huddlwenf/vedlegg_E1534A/Vedlegg_5_Applikasjon_Firmware/ble_moisture_sensor_system/pca10028/s110/arm5/JLinkLog.txt

T217C 000:562 SEGGER J-Link V4.96d Log File (0000ms, 0530ms total)
T217C 000:562 DLL Compiled: Jan 29 2015 11:45:37 (0000ms, 0530ms total)
T217C 000:562 Logging started @ 2015-05-24 15:23 (0000ms, 0530ms total)
T217C 000:563 JLINK_SetWarnOutHandler(...) (0000ms, 0530ms total)
T217C 000:563 JLINK_OpenEx(...)
Firmware: J-Link OB-SAM3U128-V2-NordicSemi compiled Nov 28 2014 10:32:04
Hardware: V1.00
S/N: 681368549  returns O.K. (0266ms, 0796ms total)
T217C 000:829 JLINK_SetErrorOutHandler(...) (0000ms, 0796ms total)
T217C 000:829 JLINK_ExecCommand("ProjectFile = "C:\Users\Joakim\Downloads\ble_peripheral\ble_moisture_sensor_system\pca10028\s110\arm5\JLinkSettings.ini"", ...)  returns 0x00 (0001ms, 0797ms total)
T217C 000:839 JLINK_ExecCommand("Device = nRF51422_xxAC", ...)Device "NRF51422_XXAC" selected.  returns 0x00 (0004ms, 0801ms total)
T217C 000:843 JLINK_ExecCommand("DisableConnectionTimeout", ...)  returns 0x01 (0000ms, 0801ms total)
T217C 000:843 JLINK_GetHardwareVersion()  returns 0x2710 (0001ms, 0802ms total)
T217C 000:844 JLINK_GetDLLVersion()  returns 49604 (0000ms, 0802ms total)
T217C 000:844 JLINK_GetFirmwareString(...) (0000ms, 0802ms total)
T217C 000:852 JLINK_GetDLLVersion()  returns 49604 (0000ms, 0802ms total)
T217C 000:852 JLINK_GetCompileDateTime() (0000ms, 0802ms total)
T217C 000:855 JLINK_GetFirmwareString(...) (0000ms, 0802ms total)
T217C 000:860 JLINK_GetHardwareVersion()  returns 0x2710 (0000ms, 0802ms total)
T217C 000:865 JLINK_TIF_Select(JLINKARM_TIF_SWD)  returns 0x00 (0002ms, 0804ms total)
T217C 000:867 JLINK_SetSpeed(20000) (0001ms, 0805ms total)
T217C 000:868 JLINK_GetId() >0x108 TIF>Found SWD-DP with ID 0x0BB11477 >0x35 TIF> >0x0D TIF> >0x28 TIF> >0x0D TIF> >0x28 TIF> >0x35 TIF> >0x0D TIF> >0x28 TIF> >0x35 TIF> >0x35 TIF> >0x35 TIF> >0x0D TIF> >0x28 TIF> >0x0D TIF> >0x28 TIF> >0x0D TIF> >0x28 TIF> >0x35 TIF> >0x35 TIF> >0x35 TIF> >0x0D TIF> >0x28 TIF> >0x0D TIF> >0x28 TIF> >0x35 TIF> >0x0D TIF> >0x28 TIF> >0x0D TIF> >0x28 TIF> >0x0D TIF> >0x28 TIF> >0x35 TIF> >0x35 TIF> >0x0D TIF> >0x28 TIF> >0x35 TIF> >0x35 TIF>
Found Cortex-M0 r0p0, Little endian. -- CPU_WriteMem(4 bytes @ 0xE0002000) -- CPU_ReadMem(4 bytes @ 0xE000EDF0) -- CPU_ReadMem(4 bytes @ 0xE0002000)FPUnit: 4 code (BP) slots and 0 literal slots -- CPU_ReadMem(4 bytes @ 0xE000EDFC) -- CPU_ReadMem(4 bytes @ 0xE0001000) -- CPU_WriteMem(4 bytes @ 0xE0001000) -- CPU_ReadMem(4 bytes @ 0xE00FF018) >0x35 TIF>  returns 0x0BB11477 (0032ms, 0837ms total)
T217C 000:900 JLINK_GetDLLVersion()  returns 49604 (0001ms, 0838ms total)
T217C 000:901 JLINK_CORE_GetFound()  returns 0x60000FF (0000ms, 0838ms total)
T217C 000:901 JLINK_GetDebugInfo(0x100) -- Value=0xF0000003  returns 0x00 (0000ms, 0838ms total)
T217C 000:902 JLINK_ReadMem (0xF0000000, 0x0020 Bytes, ...) -- CPU is running -- CPU_ReadMem(32 bytes @ 0xF0000000) - Data: 03 F0 0F F0 03 20 00 00 00 00 00 00 00 00 00 00 ...  returns 0x00 (0002ms, 0840ms total)
T217C 000:904 JLINK_ReadMem (0xE00FFFF0, 0x0010 Bytes, ...) -- CPU is running -- CPU_ReadMem(16 bytes @ 0xE00FFFF0) - Data: 0D 00 00 00 10 00 00 00 05 00 00 00 B1 00 00 00  returns 0x00 (0000ms, 0840ms total)
T217C 000:904 JLINK_ReadMem (0xE00FFFD0, 0x0020 Bytes, ...) -- CPU is running -- CPU_ReadMem(32 bytes @ 0xE00FFFD0) - Data: 04 00 00 00 00 00 00 00 00 00 00 00 00 00 00 00 ...  returns 0x00 (0002ms, 0842ms total)
T217C 000:906 JLINK_ReadMem (0xE00FF000, 0x0020 Bytes, ...) -- CPU is running -- CPU_ReadMem(32 bytes @ 0xE00FF000) - Data: 03 F0 F0 FF 03 20 F0 FF 03 30 F0 FF 00 00 00 00 ...  returns 0x00 (0001ms, 0843ms total)
T217C 000:907 JLINK_ReadMem (0xE000EFF0, 0x0010 Bytes, ...) -- CPU is running -- CPU_ReadMem(16 bytes @ 0xE000EFF0) - Data: 0D 00 00 00 E0 00 00 00 05 00 00 00 B1 00 00 00  returns 0x00 (0001ms, 0844ms total)
T217C 000:908 JLINK_ReadMem (0xE000EFD0, 0x0020 Bytes, ...) -- CPU is running -- CPU_ReadMem(32 bytes @ 0xE000EFD0) - Data: 04 00 00 00 00 00 00 00 00 00 00 00 00 00 00 00 ...  returns 0x00 (0001ms, 0845ms total)
T217C 000:909 JLINK_ReadMem (0xE0001FF0, 0x0010 Bytes, ...) -- CPU is running -- CPU_ReadMem(16 bytes @ 0xE0001FF0) - Data: 0D 00 00 00 E0 00 00 00 05 00 00 00 B1 00 00 00  returns 0x00 (0001ms, 0846ms total)
T217C 000:910 JLINK_ReadMem (0xE0001FD0, 0x0020 Bytes, ...) -- CPU is running -- CPU_ReadMem(32 bytes @ 0xE0001FD0) - Data: 04 00 00 00 00 00 00 00 00 00 00 00 00 00 00 00 ...  returns 0x00 (0001ms, 0847ms total)
T217C 000:911 JLINK_ReadMem (0xE0002FF0, 0x0010 Bytes, ...) -- CPU is running -- CPU_ReadMem(16 bytes @ 0xE0002FF0) - Data: 0D 00 00 00 E0 00 00 00 05 00 00 00 B1 00 00 00  returns 0x00 (0001ms, 0848ms total)
T217C 000:912 JLINK_ReadMem (0xE0002FD0, 0x0020 Bytes, ...) -- CPU is running -- CPU_ReadMem(32 bytes @ 0xE0002FD0) - Data: 04 00 00 00 00 00 00 00 00 00 00 00 00 00 00 00 ...  returns 0x00 (0002ms, 0850ms total)
T217C 000:914 JLINK_ReadMem (0xF0002FF0, 0x0010 Bytes, ...) -- CPU is running -- CPU_ReadMem(16 bytes @ 0xF0002FF0) - Data: 0D 00 00 00 90 00 00 00 05 00 00 00 B1 00 00 00  returns 0x00 (0001ms, 0851ms total)
T217C 000:915 JLINK_ReadMem (0xF0002FD0, 0x0020 Bytes, ...) -- CPU is running -- CPU_ReadMem(32 bytes @ 0xF0002FD0) - Data: 04 00 00 00 00 00 00 00 00 00 00 00 00 00 00 00 ...  returns 0x00 (0001ms, 0852ms total)
T217C 000:916 JLINK_ReadMemU32(0xE000ED00, 0x0001 Items, ...) -- CPU is running -- CPU_ReadMem(4 bytes @ 0xE000ED00) - Data: 00 C2 0C 41  returns 0x01 (0001ms, 0853ms total)
T217C 000:917 JLINK_SetResetType(JLINKARM_RESET_TYPE_NORMAL)  returns JLINKARM_RESET_TYPE_NORMAL (0000ms, 0853ms total)
T217C 000:917 JLINK_Reset() -- CPU is running -- CPU_WriteMem(4 bytes @ 0xE000EDF0) -- CPU is running -- CPU_WriteMem(4 bytes @ 0xE000EDFC) >0x35 TIF> -- CPU is running -- CPU_WriteMem(4 bytes @ 0xE000ED0C) -- CPU is running -- CPU_ReadMem(4 bytes @ 0xE000EDF0) -- CPU is running -- CPU_ReadMem(4 bytes @ 0xE000EDF0) -- CPU is running -- CPU_WriteMem(4 bytes @ 0xE000EDF0) -- CPU is running -- CPU_WriteMem(4 bytes @ 0xE000EDFC) -- CPU is running -- CPU_ReadMem(4 bytes @ 0xE000EDF0)
 -- CPU_WriteMem(4 bytes @ 0xE0002000) -- CPU_ReadMem(4 bytes @ 0xE000EDFC) -- CPU_ReadMem(4 bytes @ 0xE0001000) -- CPU_WriteMem(4 bytes @ 0xE0001000) (0027ms, 0880ms total)
T217C 000:944 JLINK_Halt()  returns 0x00 (0000ms, 0880ms total)
T217C 000:944 JLINK_IsHalted()  returns TRUE (0000ms, 0880ms total)
T217C 000:944 JLINK_ReadMemU32(0xE000EDF0, 0x0001 Items, ...) -- CPU_ReadMem(4 bytes @ 0xE000EDF0) - Data: 03 00 03 00  returns 0x01 (0001ms, 0881ms total)
T217C 000:945 JLINK_WriteU32(0xE000EDF0, 0xA05F0003) -- CPU_WriteMem(4 bytes @ 0xE000EDF0)  returns 0x00 (0001ms, 0882ms total)
T217C 000:946 JLINK_WriteU32(0xE000EDFC, 0x01000000) -- CPU_WriteMem(4 bytes @ 0xE000EDFC)  returns 0x00 (0001ms, 0883ms total)
T217C 000:954 JLINK_GetHWStatus(...)  returns 0x00 (0000ms, 0883ms total)
T217C 000:960 JLINK_GetNumBPUnits(Type = 0xFFFFFF00)  returns 0x04 (0000ms, 0883ms total)
T217C 000:960 JLINK_GetNumBPUnits(Type = 0xF0)  returns 0x2000 (0000ms, 0883ms total)
T217C 000:960 JLINK_GetNumWPUnits()  returns 0x02 (0000ms, 0883ms total)
T217C 000:967 JLINK_GetSpeed()  returns 0x3E8 (0000ms, 0883ms total)
T217C 000:970 JLINK_ReadMemU32(0xE000E004, 0x0001 Items, ...) -- CPU_ReadMem(4 bytes @ 0xE000E004) - Data: 00 00 00 00  returns 0x01 (0001ms, 0884ms total)
T217C 000:971 JLINK_Halt()  returns 0x00 (0000ms, 0884ms total)
T217C 000:971 JLINK_IsHalted()  returns TRUE (0000ms, 0884ms total)
T217C 001:067 JLINK_WriteMem(0x20000000, 0x0470 Bytes, ...) - Data: 00 BE 0A E0 0D 78 2D 06 68 40 08 24 40 00 00 D3 ... -- CPU_WriteMem(1136 bytes @ 0x20000000)  returns 0x470 (0019ms, 0903ms total)
T217C 001:086 JLINK_WriteReg(R0, 0x00000000)  returns 0x00 (0000ms, 0903ms total)
T217C 001:086 JLINK_WriteReg(R1, 0x00F42400)  returns 0x00 (0000ms, 0903ms total)
T217C 001:086 JLINK_WriteReg(R2, 0x00000001)  returns 0x00 (0000ms, 0903ms total)
T217C 001:086 JLINK_WriteReg(R3, 0x00000000)  returns 0x00 (0000ms, 0903ms total)
T217C 001:086 JLINK_WriteReg(R4, 0x00000000)  returns 0x00 (0000ms, 0903ms total)
T217C 001:086 JLINK_WriteReg(R5, 0x00000000)  returns 0x00 (0000ms, 0903ms total)
T217C 001:086 JLINK_WriteReg(R6, 0x00000000)  returns 0x00 (0000ms, 0903ms total)
T217C 001:086 JLINK_WriteReg(R7, 0x00000000)  returns 0x00 (0000ms, 0903ms total)
T217C 001:086 JLINK_WriteReg(R8, 0x00000000)  returns 0x00 (0000ms, 0903ms total)
T217C 001:086 JLINK_WriteReg(R9, 0x2000046C)  returns 0x00 (0000ms, 0903ms total)
T217C 001:086 JLINK_WriteReg(R10, 0x00000000)  returns 0x00 (0000ms, 0903ms total)
T217C 001:086 JLINK_WriteReg(R11, 0x00000000)  returns 0x00 (0000ms, 0903ms total)
T217C 001:086 JLINK_WriteReg(R12, 0x00000000)  returns 0x00 (0000ms, 0903ms total)
T217C 001:086 JLINK_WriteReg(R13 (SP), 0x20001000)  returns 0x00 (0000ms, 0903ms total)
T217C 001:086 JLINK_WriteReg(R14, 0x20000001)  returns 0x00 (0000ms, 0903ms total)
T217C 001:086 JLINK_WriteReg(R15 (PC), 0x20000028)  returns 0x00 (0000ms, 0903ms total)
T217C 001:086 JLINK_WriteReg(XPSR, 0x01000000)  returns 0x00 (0000ms, 0903ms total)
T217C 001:086 JLINK_WriteReg(MSP, 0x20001000)  returns 0x00 (0000ms, 0903ms total)
T217C 001:086 JLINK_WriteReg(PSP, 0x20001000)  returns 0x00 (0000ms, 0903ms total)
T217C 001:086 JLINK_WriteReg(CFBP, 0x00000000)  returns 0x00 (0000ms, 0903ms total)
T217C 001:086 JLINK_SetBPEx(Addr = 0x20000000, Type = 0xFFFFFFF2) -- CPU_ReadMem(2 bytes @ 0x20000000)  returns 0x00000001 (0002ms, 0905ms total)
T217C 001:088 JLINK_Go() -- CPU_WriteMem(2 bytes @ 0x20000000) -- CPU_WriteMem(4 bytes @ 0xE0002008) -- CPU_WriteMem(4 bytes @ 0xE000200C) -- CPU_WriteMem(4 bytes @ 0xE0002010) -- CPU_WriteMem(4 bytes @ 0xE0002014) -- CPU_WriteMem(4 bytes @ 0xE0001004) (0009ms, 0914ms total)
T217C 001:097 JLINK_IsHalted() -- CPU_ReadMem(2 bytes @ 0x20000000)  returns TRUE (0006ms, 0920ms total)
T217C 001:103 JLINK_ReadReg(R15 (PC))  returns 0x20000000 (0000ms, 0914ms total)
T217C 001:103 JLINK_ClrBPEx(BPHandle = 0x00000001)  returns 0x00 (0000ms, 0914ms total)
T217C 001:103 JLINK_ReadReg(R0)  returns 0x00000000 (0000ms, 0914ms total)
T217C 001:104 JLINK_WriteReg(R0, 0x00018000)  returns 0x00 (0000ms, 0914ms total)
T217C 001:104 JLINK_WriteReg(R1, 0x00000400)  returns 0x00 (0000ms, 0914ms total)
T217C 001:104 JLINK_WriteReg(R2, 0x000000FF)  returns 0x00 (0000ms, 0914ms total)
T217C 001:104 JLINK_WriteReg(R3, 0x00000000)  returns 0x00 (0000ms, 0914ms total)
T217C 001:104 JLINK_WriteReg(R4, 0x00000000)  returns 0x00 (0000ms, 0914ms total)
T217C 001:104 JLINK_WriteReg(R5, 0x00000000)  returns 0x00 (0000ms, 0914ms total)
T217C 001:104 JLINK_WriteReg(R6, 0x00000000)  returns 0x00 (0000ms, 0914ms total)
T217C 001:104 JLINK_WriteReg(R7, 0x00000000)  returns 0x00 (0000ms, 0914ms total)
T217C 001:104 JLINK_WriteReg(R8, 0x00000000)  returns 0x00 (0000ms, 0914ms total)
T217C 001:104 JLINK_WriteReg(R9, 0x2000046C)  returns 0x00 (0000ms, 0914ms total)
T217C 001:104 JLINK_WriteReg(R10, 0x00000000)  returns 0x00 (0000ms, 0914ms total)
T217C 001:104 JLINK_WriteReg(R11, 0x00000000)  returns 0x00 (0000ms, 0914ms total)
T217C 001:104 JLINK_WriteReg(R12, 0x00000000)  returns 0x00 (0000ms, 0914ms total)
T217C 001:104 JLINK_WriteReg(R13 (SP), 0x20001000)  returns 0x00 (0000ms, 0914ms total)
T217C 001:105 JLINK_WriteReg(R14, 0x20000001)  returns 0x00 (0000ms, 0914ms total)
T217C 001:105 JLINK_WriteReg(R15 (PC), 0x20000182)  returns 0x00 (0000ms, 0914ms total)
T217C 001:105 JLINK_WriteReg(XPSR, 0x01000000)  returns 0x00 (0000ms, 0914ms total)
T217C 001:105 JLINK_WriteReg(MSP, 0x20001000)  returns 0x00 (0000ms, 0914ms total)
T217C 001:105 JLINK_WriteReg(PSP, 0x20001000)  returns 0x00 (0000ms, 0914ms total)
T217C 001:105 JLINK_WriteReg(CFBP, 0x00000000)  returns 0x00 (0000ms, 0914ms total)
T217C 001:105 JLINK_SetBPEx(Addr = 0x20000000, Type = 0xFFFFFFF2)  returns 0x00000002 (0000ms, 0914ms total)
T217C 001:105 JLINK_Go() (0003ms, 0917ms total)
T217C 001:108 JLINK_IsHalted() -- CPU_ReadMem(2 bytes @ 0x20000000)  returns TRUE (0006ms, 0923ms total)
T217C 001:114 JLINK_ReadReg(R15 (PC))  returns 0x20000000 (0000ms, 0917ms total)
T217C 001:114 JLINK_ClrBPEx(BPHandle = 0x00000002)  returns 0x00 (0000ms, 0917ms total)
T217C 001:114 JLINK_ReadReg(R0)  returns 0x00000001 (0000ms, 0917ms total)
T217C 001:114 JLINK_WriteReg(R0, 0x00018000)  returns 0x00 (0000ms, 0917ms total)
T217C 001:114 JLINK_WriteReg(R1, 0x00000400)  returns 0x00 (0000ms, 0917ms total)
T217C 001:114 JLINK_WriteReg(R2, 0x000000FF)  returns 0x00 (0000ms, 0917ms total)
T217C 001:114 JLINK_WriteReg(R3, 0x00000000)  returns 0x00 (0001ms, 0918ms total)
T217C 001:115 JLINK_WriteReg(R4, 0x00000000)  returns 0x00 (0000ms, 0918ms total)
T217C 001:115 JLINK_WriteReg(R5, 0x00000000)  returns 0x00 (0000ms, 0918ms total)
T217C 001:115 JLINK_WriteReg(R6, 0x00000000)  returns 0x00 (0000ms, 0918ms total)
T217C 001:115 JLINK_WriteReg(R7, 0x00000000)  returns 0x00 (0000ms, 0918ms total)
T217C 001:115 JLINK_WriteReg(R8, 0x00000000)  returns 0x00 (0000ms, 0918ms total)
T217C 001:115 JLINK_WriteReg(R9, 0x2000046C)  returns 0x00 (0000ms, 0918ms total)
T217C 001:115 JLINK_WriteReg(R10, 0x00000000)  returns 0x00 (0000ms, 0918ms total)
T217C 001:115 JLINK_WriteReg(R11, 0x00000000)  returns 0x00 (0000ms, 0918ms total)
T217C 001:115 JLINK_WriteReg(R12, 0x00000000)  returns 0x00 (0000ms, 0918ms total)
T217C 001:115 JLINK_WriteReg(R13 (SP), 0x20001000)  returns 0x00 (0000ms, 0918ms total)
T217C 001:115 JLINK_WriteReg(R14, 0x20000001)  returns 0x00 (0000ms, 0918ms total)
T217C 001:115 JLINK_WriteReg(R15 (PC), 0x200000FE)  returns 0x00 (0000ms, 0918ms total)
T217C 001:115 JLINK_WriteReg(XPSR, 0x01000000)  returns 0x00 (0000ms, 0918ms total)
T217C 001:115 JLINK_WriteReg(MSP, 0x20001000)  returns 0x00 (0000ms, 0918ms total)
T217C 001:115 JLINK_WriteReg(PSP, 0x20001000)  returns 0x00 (0000ms, 0918ms total)
T217C 001:115 JLINK_WriteReg(CFBP, 0x00000000)  returns 0x00 (0000ms, 0918ms total)
T217C 001:115 JLINK_SetBPEx(Addr = 0x20000000, Type = 0xFFFFFFF2)  returns 0x00000003 (0000ms, 0918ms total)
T217C 001:115 JLINK_Go() (0003ms, 0921ms total)
T217C 001:118 JLINK_IsHalted()  returns FALSE (0001ms, 0922ms total)
T217C 001:180 JLINK_IsHalted() -- CPU_ReadMem(2 bytes @ 0x20000000)  returns TRUE (0005ms, 0926ms total)
T217C 001:185 JLINK_ReadReg(R15 (PC))  returns 0x20000000 (0000ms, 0921ms total)
T217C 001:185 JLINK_ClrBPEx(BPHandle = 0x00000003)  returns 0x00 (0000ms, 0921ms total)
T217C 001:185 JLINK_ReadReg(R0)  returns 0x00000000 (0000ms, 0921ms total)
T217C 001:186 JLINK_WriteReg(R0, 0x00018400)  returns 0x00 (0000ms, 0921ms total)
T217C 001:186 JLINK_WriteReg(R1, 0x00000400)  returns 0x00 (0000ms, 0921ms total)
T217C 001:186 JLINK_WriteReg(R2, 0x000000FF)  returns 0x00 (0000ms, 0921ms total)
T217C 001:186 JLINK_WriteReg(R3, 0x00000000)  returns 0x00 (0000ms, 0921ms total)
T217C 001:186 JLINK_WriteReg(R4, 0x00000000)  returns 0x00 (0000ms, 0921ms total)
T217C 001:186 JLINK_WriteReg(R5, 0x00000000)  returns 0x00 (0000ms, 0921ms total)
T217C 001:186 JLINK_WriteReg(R6, 0x00000000)  returns 0x00 (0000ms, 0921ms total)
T217C 001:186 JLINK_WriteReg(R7, 0x00000000)  returns 0x00 (0000ms, 0921ms total)
T217C 001:186 JLINK_WriteReg(R8, 0x00000000)  returns 0x00 (0000ms, 0921ms total)
T217C 001:186 JLINK_WriteReg(R9, 0x2000046C)  returns 0x00 (0000ms, 0921ms total)
T217C 001:186 JLINK_WriteReg(R10, 0x00000000)  returns 0x00 (0001ms, 0922ms total)
T217C 001:187 JLINK_WriteReg(R11, 0x00000000)  returns 0x00 (0000ms, 0922ms total)
T217C 001:187 JLINK_WriteReg(R12, 0x00000000)  returns 0x00 (0000ms, 0922ms total)
T217C 001:187 JLINK_WriteReg(R13 (SP), 0x20001000)  returns 0x00 (0000ms, 0922ms total)
T217C 001:187 JLINK_WriteReg(R14, 0x20000001)  returns 0x00 (0000ms, 0922ms total)
T217C 001:187 JLINK_WriteReg(R15 (PC), 0x20000182)  returns 0x00 (0000ms, 0922ms total)
T217C 001:187 JLINK_WriteReg(XPSR, 0x01000000)  returns 0x00 (0000ms, 0922ms total)
T217C 001:187 JLINK_WriteReg(MSP, 0x20001000)  returns 0x00 (0000ms, 0922ms total)
T217C 001:187 JLINK_WriteReg(PSP, 0x20001000)  returns 0x00 (0000ms, 0922ms total)
T217C 001:187 JLINK_WriteReg(CFBP, 0x00000000)  returns 0x00 (0000ms, 0922ms total)
T217C 001:187 JLINK_SetBPEx(Addr = 0x20000000, Type = 0xFFFFFFF2)  returns 0x00000004 (0000ms, 0922ms total)
T217C 001:187 JLINK_Go() (0002ms, 0924ms total)
T217C 001:189 JLINK_IsHalted() -- CPU_ReadMem(2 bytes @ 0x20000000)  returns TRUE (0006ms, 0930ms total)
T217C 001:195 JLINK_ReadReg(R15 (PC))  returns 0x20000000 (0000ms, 0924ms total)
T217C 001:195 JLINK_ClrBPEx(BPHandle = 0x00000004)  returns 0x00 (0000ms, 0924ms total)
T217C 001:195 JLINK_ReadReg(R0)  returns 0x00000001 (0000ms, 0924ms total)
T217C 001:195 JLINK_WriteReg(R0, 0x00018400)  returns 0x00 (0000ms, 0924ms total)
T217C 001:195 JLINK_WriteReg(R1, 0x00000400)  returns 0x00 (0000ms, 0924ms total)
T217C 001:195 JLINK_WriteReg(R2, 0x000000FF)  returns 0x00 (0000ms, 0924ms total)
T217C 001:195 JLINK_WriteReg(R3, 0x00000000)  returns 0x00 (0000ms, 0924ms total)
T217C 001:195 JLINK_WriteReg(R4, 0x00000000)  returns 0x00 (0000ms, 0924ms total)
T217C 001:195 JLINK_WriteReg(R5, 0x00000000)  returns 0x00 (0000ms, 0924ms total)
T217C 001:195 JLINK_WriteReg(R6, 0x00000000)  returns 0x00 (0000ms, 0924ms total)
T217C 001:195 JLINK_WriteReg(R7, 0x00000000)  returns 0x00 (0000ms, 0924ms total)
T217C 001:195 JLINK_WriteReg(R8, 0x00000000)  returns 0x00 (0000ms, 0924ms total)
T217C 001:195 JLINK_WriteReg(R9, 0x2000046C)  returns 0x00 (0000ms, 0924ms total)
T217C 001:195 JLINK_WriteReg(R10, 0x00000000)  returns 0x00 (0000ms, 0924ms total)
T217C 001:195 JLINK_WriteReg(R11, 0x00000000)  returns 0x00 (0000ms, 0924ms total)
T217C 001:195 JLINK_WriteReg(R12, 0x00000000)  returns 0x00 (0000ms, 0924ms total)
T217C 001:195 JLINK_WriteReg(R13 (SP), 0x20001000)  returns 0x00 (0000ms, 0924ms total)
T217C 001:195 JLINK_WriteReg(R14, 0x20000001)  returns 0x00 (0000ms, 0924ms total)
T217C 001:195 JLINK_WriteReg(R15 (PC), 0x200000FE)  returns 0x00 (0000ms, 0924ms total)
T217C 001:195 JLINK_WriteReg(XPSR, 0x01000000)  returns 0x00 (0000ms, 0924ms total)
T217C 001:195 JLINK_WriteReg(MSP, 0x20001000)  returns 0x00 (0000ms, 0924ms total)
T217C 001:195 JLINK_WriteReg(PSP, 0x20001000)  returns 0x00 (0000ms, 0924ms total)
T217C 001:195 JLINK_WriteReg(CFBP, 0x00000000)  returns 0x00 (0000ms, 0924ms total)
T217C 001:195 JLINK_SetBPEx(Addr = 0x20000000, Type = 0xFFFFFFF2)  returns 0x00000005 (0000ms, 0924ms total)
T217C 001:195 JLINK_Go() (0002ms, 0926ms total)
T217C 001:197 JLINK_IsHalted()  returns FALSE (0001ms, 0927ms total)
T217C 001:200 JLINK_IsHalted()  returns FALSE (0001ms, 0927ms total)
T217C 001:205 JLINK_IsHalted()  returns FALSE (0001ms, 0927ms total)
T217C 001:208 JLINK_IsHalted()  returns FALSE (0000ms, 0926ms total)
T217C 001:210 JLINK_IsHalted()  returns FALSE (0001ms, 0927ms total)
T217C 001:213 JLINK_IsHalted()  returns FALSE (0000ms, 0926ms total)
T217C 001:215 JLINK_IsHalted()  returns FALSE (0001ms, 0927ms total)
T217C 001:219 JLINK_IsHalted() -- CPU_ReadMem(2 bytes @ 0x20000000)  returns TRUE (0005ms, 0931ms total)
T217C 001:224 JLINK_ReadReg(R15 (PC))  returns 0x20000000 (0000ms, 0926ms total)
T217C 001:224 JLINK_ClrBPEx(BPHandle = 0x00000005)  returns 0x00 (0000ms, 0926ms total)
T217C 001:224 JLINK_ReadReg(R0)  returns 0x00000000 (0000ms, 0926ms total)
T217C 001:225 JLINK_WriteReg(R0, 0x00018800)  returns 0x00 (0000ms, 0926ms total)
T217C 001:225 JLINK_WriteReg(R1, 0x00000400)  returns 0x00 (0000ms, 0926ms total)
T217C 001:225 JLINK_WriteReg(R2, 0x000000FF)  returns 0x00 (0000ms, 0926ms total)
T217C 001:225 JLINK_WriteReg(R3, 0x00000000)  returns 0x00 (0000ms, 0926ms total)
T217C 001:225 JLINK_WriteReg(R4, 0x00000000)  returns 0x00 (0000ms, 0926ms total)
T217C 001:225 JLINK_WriteReg(R5, 0x00000000)  returns 0x00 (0000ms, 0926ms total)
T217C 001:225 JLINK_WriteReg(R6, 0x00000000)  returns 0x00 (0000ms, 0926ms total)
T217C 001:225 JLINK_WriteReg(R7, 0x00000000)  returns 0x00 (0000ms, 0926ms total)
T217C 001:225 JLINK_WriteReg(R8, 0x00000000)  returns 0x00 (0000ms, 0926ms total)
T217C 001:225 JLINK_WriteReg(R9, 0x2000046C)  returns 0x00 (0000ms, 0926ms total)
T217C 001:225 JLINK_WriteReg(R10, 0x00000000)  returns 0x00 (0000ms, 0926ms total)
T217C 001:225 JLINK_WriteReg(R11, 0x00000000)  returns 0x00 (0000ms, 0926ms total)
T217C 001:225 JLINK_WriteReg(R12, 0x00000000)  returns 0x00 (0000ms, 0926ms total)
T217C 001:225 JLINK_WriteReg(R13 (SP), 0x20001000)  returns 0x00 (0000ms, 0926ms total)
T217C 001:225 JLINK_WriteReg(R14, 0x20000001)  returns 0x00 (0000ms, 0926ms total)
T217C 001:225 JLINK_WriteReg(R15 (PC), 0x20000182)  returns 0x00 (0000ms, 0926ms total)
T217C 001:225 JLINK_WriteReg(XPSR, 0x01000000)  returns 0x00 (0000ms, 0926ms total)
T217C 001:225 JLINK_WriteReg(MSP, 0x20001000)  returns 0x00 (0000ms, 0926ms total)
T217C 001:225 JLINK_WriteReg(PSP, 0x20001000)  returns 0x00 (0000ms, 0926ms total)
T217C 001:225 JLINK_WriteReg(CFBP, 0x00000000)  returns 0x00 (0000ms, 0926ms total)
T217C 001:225 JLINK_SetBPEx(Addr = 0x20000000, Type = 0xFFFFFFF2)  returns 0x00000006 (0000ms, 0926ms total)
T217C 001:225 JLINK_Go() (0003ms, 0929ms total)
T217C 001:228 JLINK_IsHalted() -- CPU_ReadMem(2 bytes @ 0x20000000)  returns TRUE (0006ms, 0935ms total)
T217C 001:234 JLINK_ReadReg(R15 (PC))  returns 0x20000000 (0000ms, 0929ms total)
T217C 001:234 JLINK_ClrBPEx(BPHandle = 0x00000006)  returns 0x00 (0000ms, 0929ms total)
T217C 001:234 JLINK_ReadReg(R0)  returns 0x00000001 (0000ms, 0929ms total)
T217C 001:234 JLINK_WriteReg(R0, 0x00018800)  returns 0x00 (0000ms, 0929ms total)
T217C 001:234 JLINK_WriteReg(R1, 0x00000400)  returns 0x00 (0000ms, 0929ms total)
T217C 001:234 JLINK_WriteReg(R2, 0x000000FF)  returns 0x00 (0000ms, 0929ms total)
T217C 001:234 JLINK_WriteReg(R3, 0x00000000)  returns 0x00 (0000ms, 0929ms total)
T217C 001:234 JLINK_WriteReg(R4, 0x00000000)  returns 0x00 (0000ms, 0929ms total)
T217C 001:234 JLINK_WriteReg(R5, 0x00000000)  returns 0x00 (0000ms, 0929ms total)
T217C 001:234 JLINK_WriteReg(R6, 0x00000000)  returns 0x00 (0000ms, 0929ms total)
T217C 001:234 JLINK_WriteReg(R7, 0x00000000)  returns 0x00 (0000ms, 0929ms total)
T217C 001:234 JLINK_WriteReg(R8, 0x00000000)  returns 0x00 (0000ms, 0929ms total)
T217C 001:234 JLINK_WriteReg(R9, 0x2000046C)  returns 0x00 (0000ms, 0929ms total)
T217C 001:234 JLINK_WriteReg(R10, 0x00000000)  returns 0x00 (0000ms, 0929ms total)
T217C 001:234 JLINK_WriteReg(R11, 0x00000000)  returns 0x00 (0000ms, 0929ms total)
T217C 001:234 JLINK_WriteReg(R12, 0x00000000)  returns 0x00 (0000ms, 0929ms total)
T217C 001:234 JLINK_WriteReg(R13 (SP), 0x20001000)  returns 0x00 (0000ms, 0929ms total)
T217C 001:234 JLINK_WriteReg(R14, 0x20000001)  returns 0x00 (0000ms, 0929ms total)
T217C 001:234 JLINK_WriteReg(R15 (PC), 0x200000FE)  returns 0x00 (0000ms, 0929ms total)
T217C 001:234 JLINK_WriteReg(XPSR, 0x01000000)  returns 0x00 (0000ms, 0929ms total)
T217C 001:234 JLINK_WriteReg(MSP, 0x20001000)  returns 0x00 (0000ms, 0929ms total)
T217C 001:234 JLINK_WriteReg(PSP, 0x20001000)  returns 0x00 (0000ms, 0929ms total)
T217C 001:234 JLINK_WriteReg(CFBP, 0x00000000)  returns 0x00 (0000ms, 0929ms total)
T217C 001:234 JLINK_SetBPEx(Addr = 0x20000000, Type = 0xFFFFFFF2)  returns 0x00000007 (0000ms, 0929ms total)
T217C 001:234 JLINK_Go() (0003ms, 0932ms total)
T217C 001:237 JLINK_IsHalted()  returns FALSE (0000ms, 0932ms total)
T217C 001:239 JLINK_IsHalted()  returns FALSE (0000ms, 0932ms total)
T217C 001:241 JLINK_IsHalted()  returns FALSE (0000ms, 0932ms total)
T217C 001:243 JLINK_IsHalted()  returns FALSE (0000ms, 0932ms total)
T217C 001:245 JLINK_IsHalted()  returns FALSE (0000ms, 0932ms total)
T217C 001:247 JLINK_IsHalted()  returns FALSE (0001ms, 0933ms total)
T217C 001:250 JLINK_IsHalted()  returns FALSE (0001ms, 0933ms total)
T217C 001:253 JLINK_IsHalted()  returns FALSE (0001ms, 0933ms total)
T217C 001:256 JLINK_IsHalted()  returns FALSE (0001ms, 0933ms total)
T217C 001:259 JLINK_IsHalted() -- CPU_ReadMem(2 bytes @ 0x20000000)  returns TRUE (0005ms, 0937ms total)
T217C 001:264 JLINK_ReadReg(R15 (PC))  returns 0x20000000 (0000ms, 0932ms total)
T217C 001:264 JLINK_ClrBPEx(BPHandle = 0x00000007)  returns 0x00 (0000ms, 0932ms total)
T217C 001:264 JLINK_ReadReg(R0)  returns 0x00000000 (0000ms, 0932ms total)
T217C 001:265 JLINK_WriteReg(R0, 0x00018C00)  returns 0x00 (0000ms, 0932ms total)
T217C 001:265 JLINK_WriteReg(R1, 0x00000400)  returns 0x00 (0000ms, 0932ms total)
T217C 001:265 JLINK_WriteReg(R2, 0x000000FF)  returns 0x00 (0000ms, 0932ms total)
T217C 001:265 JLINK_WriteReg(R3, 0x00000000)  returns 0x00 (0000ms, 0932ms total)
T217C 001:265 JLINK_WriteReg(R4, 0x00000000)  returns 0x00 (0000ms, 0932ms total)
T217C 001:265 JLINK_WriteReg(R5, 0x00000000)  returns 0x00 (0000ms, 0932ms total)
T217C 001:265 JLINK_WriteReg(R6, 0x00000000)  returns 0x00 (0000ms, 0932ms total)
T217C 001:265 JLINK_WriteReg(R7, 0x00000000)  returns 0x00 (0000ms, 0932ms total)
T217C 001:265 JLINK_WriteReg(R8, 0x00000000)  returns 0x00 (0000ms, 0932ms total)
T217C 001:265 JLINK_WriteReg(R9, 0x2000046C)  returns 0x00 (0000ms, 0932ms total)
T217C 001:265 JLINK_WriteReg(R10, 0x00000000)  returns 0x00 (0000ms, 0932ms total)
T217C 001:265 JLINK_WriteReg(R11, 0x00000000)  returns 0x00 (0000ms, 0932ms total)
T217C 001:265 JLINK_WriteReg(R12, 0x00000000)  returns 0x00 (0000ms, 0932ms total)
T217C 001:265 JLINK_WriteReg(R13 (SP), 0x20001000)  returns 0x00 (0000ms, 0932ms total)
T217C 001:265 JLINK_WriteReg(R14, 0x20000001)  returns 0x00 (0000ms, 0932ms total)
T217C 001:265 JLINK_WriteReg(R15 (PC), 0x20000182)  returns 0x00 (0000ms, 0932ms total)
T217C 001:265 JLINK_WriteReg(XPSR, 0x01000000)  returns 0x00 (0000ms, 0932ms total)
T217C 001:265 JLINK_WriteReg(MSP, 0x20001000)  returns 0x00 (0000ms, 0932ms total)
T217C 001:265 JLINK_WriteReg(PSP, 0x20001000)  returns 0x00 (0000ms, 0932ms total)
T217C 001:265 JLINK_WriteReg(CFBP, 0x00000000)  returns 0x00 (0000ms, 0932ms total)
T217C 001:265 JLINK_SetBPEx(Addr = 0x20000000, Type = 0xFFFFFFF2)  returns 0x00000008 (0000ms, 0932ms total)
T217C 001:265 JLINK_Go() (0003ms, 0935ms total)
T217C 001:268 JLINK_IsHalted() -- CPU_ReadMem(2 bytes @ 0x20000000)  returns TRUE (0006ms, 0941ms total)
T217C 001:274 JLINK_ReadReg(R15 (PC))  returns 0x20000000 (0000ms, 0935ms total)
T217C 001:274 JLINK_ClrBPEx(BPHandle = 0x00000008)  returns 0x00 (0000ms, 0935ms total)
T217C 001:274 JLINK_ReadReg(R0)  returns 0x00000001 (0000ms, 0935ms total)
T217C 001:274 JLINK_WriteReg(R0, 0x00018C00)  returns 0x00 (0000ms, 0935ms total)
T217C 001:274 JLINK_WriteReg(R1, 0x00000400)  returns 0x00 (0000ms, 0935ms total)
T217C 001:274 JLINK_WriteReg(R2, 0x000000FF)  returns 0x00 (0000ms, 0935ms total)
T217C 001:274 JLINK_WriteReg(R3, 0x00000000)  returns 0x00 (0000ms, 0935ms total)
T217C 001:274 JLINK_WriteReg(R4, 0x00000000)  returns 0x00 (0000ms, 0935ms total)
T217C 001:274 JLINK_WriteReg(R5, 0x00000000)  returns 0x00 (0000ms, 0935ms total)
T217C 001:274 JLINK_WriteReg(R6, 0x00000000)  returns 0x00 (0000ms, 0935ms total)
T217C 001:274 JLINK_WriteReg(R7, 0x00000000)  returns 0x00 (0000ms, 0935ms total)
T217C 001:274 JLINK_WriteReg(R8, 0x00000000)  returns 0x00 (0000ms, 0935ms total)
T217C 001:274 JLINK_WriteReg(R9, 0x2000046C)  returns 0x00 (0000ms, 0935ms total)
T217C 001:274 JLINK_WriteReg(R10, 0x00000000)  returns 0x00 (0000ms, 0935ms total)
T217C 001:274 JLINK_WriteReg(R11, 0x00000000)  returns 0x00 (0000ms, 0935ms total)
T217C 001:274 JLINK_WriteReg(R12, 0x00000000)  returns 0x00 (0000ms, 0935ms total)
T217C 001:274 JLINK_WriteReg(R13 (SP), 0x20001000)  returns 0x00 (0000ms, 0935ms total)
T217C 001:274 JLINK_WriteReg(R14, 0x20000001)  returns 0x00 (0000ms, 0935ms total)
T217C 001:274 JLINK_WriteReg(R15 (PC), 0x200000FE)  returns 0x00 (0000ms, 0935ms total)
T217C 001:274 JLINK_WriteReg(XPSR, 0x01000000)  returns 0x00 (0000ms, 0935ms total)
T217C 001:274 JLINK_WriteReg(MSP, 0x20001000)  returns 0x00 (0000ms, 0935ms total)
T217C 001:274 JLINK_WriteReg(PSP, 0x20001000)  returns 0x00 (0000ms, 0935ms total)
T217C 001:274 JLINK_WriteReg(CFBP, 0x00000000)  returns 0x00 (0000ms, 0935ms total)
T217C 001:274 JLINK_SetBPEx(Addr = 0x20000000, Type = 0xFFFFFFF2)  returns 0x00000009 (0001ms, 0936ms total)
T217C 001:275 JLINK_Go() (0002ms, 0938ms total)
T217C 001:277 JLINK_IsHalted()  returns FALSE (0001ms, 0939ms total)
T217C 001:280 JLINK_IsHalted()  returns FALSE (0001ms, 0939ms total)
T217C 001:283 JLINK_IsHalted()  returns FALSE (0001ms, 0939ms total)
T217C 001:286 JLINK_IsHalted()  returns FALSE (0000ms, 0938ms total)
T217C 001:288 JLINK_IsHalted()  returns FALSE (0000ms, 0938ms total)
T217C 001:290 JLINK_IsHalted()  returns FALSE (0000ms, 0938ms total)
T217C 001:292 JLINK_IsHalted()  returns FALSE (0001ms, 0939ms total)
T217C 001:295 JLINK_IsHalted()  returns FALSE (0001ms, 0939ms total)
T217C 001:298 JLINK_IsHalted() -- CPU_ReadMem(2 bytes @ 0x20000000)  returns TRUE (0005ms, 0943ms total)
T217C 001:303 JLINK_ReadReg(R15 (PC))  returns 0x20000000 (0000ms, 0938ms total)
T217C 001:303 JLINK_ClrBPEx(BPHandle = 0x00000009)  returns 0x00 (0000ms, 0938ms total)
T217C 001:303 JLINK_ReadReg(R0)  returns 0x00000000 (0000ms, 0938ms total)
T217C 001:304 JLINK_WriteReg(R0, 0x00019000)  returns 0x00 (0000ms, 0938ms total)
T217C 001:304 JLINK_WriteReg(R1, 0x00000400)  returns 0x00 (0000ms, 0938ms total)
T217C 001:304 JLINK_WriteReg(R2, 0x000000FF)  returns 0x00 (0000ms, 0938ms total)
T217C 001:304 JLINK_WriteReg(R3, 0x00000000)  returns 0x00 (0000ms, 0938ms total)
T217C 001:304 JLINK_WriteReg(R4, 0x00000000)  returns 0x00 (0000ms, 0938ms total)
T217C 001:304 JLINK_WriteReg(R5, 0x00000000)  returns 0x00 (0000ms, 0938ms total)
T217C 001:304 JLINK_WriteReg(R6, 0x00000000)  returns 0x00 (0000ms, 0938ms total)
T217C 001:304 JLINK_WriteReg(R7, 0x00000000)  returns 0x00 (0000ms, 0938ms total)
T217C 001:304 JLINK_WriteReg(R8, 0x00000000)  returns 0x00 (0000ms, 0938ms total)
T217C 001:304 JLINK_WriteReg(R9, 0x2000046C)  returns 0x00 (0000ms, 0938ms total)
T217C 001:304 JLINK_WriteReg(R10, 0x00000000)  returns 0x00 (0000ms, 0938ms total)
T217C 001:304 JLINK_WriteReg(R11, 0x00000000)  returns 0x00 (0000ms, 0938ms total)
T217C 001:304 JLINK_WriteReg(R12, 0x00000000)  returns 0x00 (0000ms, 0938ms total)
T217C 001:304 JLINK_WriteReg(R13 (SP), 0x20001000)  returns 0x00 (0000ms, 0938ms total)
T217C 001:304 JLINK_WriteReg(R14, 0x20000001)  returns 0x00 (0000ms, 0938ms total)
T217C 001:304 JLINK_WriteReg(R15 (PC), 0x20000182)  returns 0x00 (0000ms, 0938ms total)
T217C 001:304 JLINK_WriteReg(XPSR, 0x01000000)  returns 0x00 (0000ms, 0938ms total)
T217C 001:304 JLINK_WriteReg(MSP, 0x20001000)  returns 0x00 (0000ms, 0938ms total)
T217C 001:304 JLINK_WriteReg(PSP, 0x20001000)  returns 0x00 (0000ms, 0938ms total)
T217C 001:304 JLINK_WriteReg(CFBP, 0x00000000)  returns 0x00 (0000ms, 0938ms total)
T217C 001:304 JLINK_SetBPEx(Addr = 0x20000000, Type = 0xFFFFFFF2)  returns 0x0000000A (0000ms, 0938ms total)
T217C 001:304 JLINK_Go() (0003ms, 0941ms total)
T217C 001:307 JLINK_IsHalted() -- CPU_ReadMem(2 bytes @ 0x20000000)  returns TRUE (0006ms, 0947ms total)
T217C 001:313 JLINK_ReadReg(R15 (PC))  returns 0x20000000 (0000ms, 0941ms total)
T217C 001:313 JLINK_ClrBPEx(BPHandle = 0x0000000A)  returns 0x00 (0000ms, 0941ms total)
T217C 001:313 JLINK_ReadReg(R0)  returns 0x00000001 (0000ms, 0941ms total)
T217C 001:313 JLINK_WriteReg(R0, 0x00019000)  returns 0x00 (0000ms, 0941ms total)
T217C 001:313 JLINK_WriteReg(R1, 0x00000400)  returns 0x00 (0000ms, 0941ms total)
T217C 001:313 JLINK_WriteReg(R2, 0x000000FF)  returns 0x00 (0000ms, 0941ms total)
T217C 001:313 JLINK_WriteReg(R3, 0x00000000)  returns 0x00 (0000ms, 0941ms total)
T217C 001:313 JLINK_WriteReg(R4, 0x00000000)  returns 0x00 (0000ms, 0941ms total)
T217C 001:313 JLINK_WriteReg(R5, 0x00000000)  returns 0x00 (0000ms, 0941ms total)
T217C 001:313 JLINK_WriteReg(R6, 0x00000000)  returns 0x00 (0000ms, 0941ms total)
T217C 001:313 JLINK_WriteReg(R7, 0x00000000)  returns 0x00 (0000ms, 0941ms total)
T217C 001:313 JLINK_WriteReg(R8, 0x00000000)  returns 0x00 (0000ms, 0941ms total)
T217C 001:313 JLINK_WriteReg(R9, 0x2000046C)  returns 0x00 (0000ms, 0941ms total)
T217C 001:313 JLINK_WriteReg(R10, 0x00000000)  returns 0x00 (0000ms, 0941ms total)
T217C 001:313 JLINK_WriteReg(R11, 0x00000000)  returns 0x00 (0001ms, 0942ms total)
T217C 001:314 JLINK_WriteReg(R12, 0x00000000)  returns 0x00 (0000ms, 0942ms total)
T217C 001:314 JLINK_WriteReg(R13 (SP), 0x20001000)  returns 0x00 (0000ms, 0942ms total)
T217C 001:314 JLINK_WriteReg(R14, 0x20000001)  returns 0x00 (0000ms, 0942ms total)
T217C 001:314 JLINK_WriteReg(R15 (PC), 0x200000FE)  returns 0x00 (0000ms, 0942ms total)
T217C 001:314 JLINK_WriteReg(XPSR, 0x01000000)  returns 0x00 (0000ms, 0942ms total)
T217C 001:314 JLINK_WriteReg(MSP, 0x20001000)  returns 0x00 (0000ms, 0942ms total)
T217C 001:314 JLINK_WriteReg(PSP, 0x20001000)  returns 0x00 (0000ms, 0942ms total)
T217C 001:314 JLINK_WriteReg(CFBP, 0x00000000)  returns 0x00 (0000ms, 0942ms total)
T217C 001:314 JLINK_SetBPEx(Addr = 0x20000000, Type = 0xFFFFFFF2)  returns 0x0000000B (0000ms, 0942ms total)
T217C 001:314 JLINK_Go() (0003ms, 0945ms total)
T217C 001:317 JLINK_IsHalted()  returns FALSE (0001ms, 0946ms total)
T217C 001:325 JLINK_IsHalted()  returns FALSE (0001ms, 0946ms total)
T217C 001:328 JLINK_IsHalted()  returns FALSE (0001ms, 0946ms total)
T217C 001:331 JLINK_IsHalted()  returns FALSE (0001ms, 0946ms total)
T217C 001:334 JLINK_IsHalted()  returns FALSE (0001ms, 0946ms total)
T217C 001:337 JLINK_IsHalted()  returns FALSE (0001ms, 0946ms total)
T217C 001:340 JLINK_IsHalted() -- CPU_ReadMem(2 bytes @ 0x20000000)  returns TRUE (0006ms, 0951ms total)
T217C 001:346 JLINK_ReadReg(R15 (PC))  returns 0x20000000 (0000ms, 0945ms total)
T217C 001:346 JLINK_ClrBPEx(BPHandle = 0x0000000B)  returns 0x00 (0000ms, 0945ms total)
T217C 001:346 JLINK_ReadReg(R0)  returns 0x00000000 (0000ms, 0945ms total)
T217C 001:346 JLINK_WriteReg(R0, 0x00019400)  returns 0x00 (0000ms, 0945ms total)
T217C 001:346 JLINK_WriteReg(R1, 0x00000400)  returns 0x00 (0000ms, 0945ms total)
T217C 001:346 JLINK_WriteReg(R2, 0x000000FF)  returns 0x00 (0000ms, 0945ms total)
T217C 001:347 JLINK_WriteReg(R3, 0x00000000)  returns 0x00 (0000ms, 0946ms total)
T217C 001:347 JLINK_WriteReg(R4, 0x00000000)  returns 0x00 (0000ms, 0946ms total)
T217C 001:347 JLINK_WriteReg(R5, 0x00000000)  returns 0x00 (0000ms, 0946ms total)
T217C 001:347 JLINK_WriteReg(R6, 0x00000000)  returns 0x00 (0000ms, 0946ms total)
T217C 001:347 JLINK_WriteReg(R7, 0x00000000)  returns 0x00 (0000ms, 0946ms total)
T217C 001:347 JLINK_WriteReg(R8, 0x00000000)  returns 0x00 (0000ms, 0946ms total)
T217C 001:347 JLINK_WriteReg(R9, 0x2000046C)  returns 0x00 (0000ms, 0946ms total)
T217C 001:347 JLINK_WriteReg(R10, 0x00000000)  returns 0x00 (0000ms, 0946ms total)
T217C 001:347 JLINK_WriteReg(R11, 0x00000000)  returns 0x00 (0000ms, 0946ms total)
T217C 001:347 JLINK_WriteReg(R12, 0x00000000)  returns 0x00 (0000ms, 0946ms total)
T217C 001:347 JLINK_WriteReg(R13 (SP), 0x20001000)  returns 0x00 (0000ms, 0946ms total)
T217C 001:347 JLINK_WriteReg(R14, 0x20000001)  returns 0x00 (0000ms, 0946ms total)
T217C 001:347 JLINK_WriteReg(R15 (PC), 0x20000182)  returns 0x00 (0000ms, 0946ms total)
T217C 001:347 JLINK_WriteReg(XPSR, 0x01000000)  returns 0x00 (0000ms, 0946ms total)
T217C 001:347 JLINK_WriteReg(MSP, 0x20001000)  returns 0x00 (0000ms, 0946ms total)
T217C 001:347 JLINK_WriteReg(PSP, 0x20001000)  returns 0x00 (0000ms, 0946ms total)
T217C 001:347 JLINK_WriteReg(CFBP, 0x00000000)  returns 0x00 (0000ms, 0946ms total)
T217C 001:347 JLINK_SetBPEx(Addr = 0x20000000, Type = 0xFFFFFFF2)  returns 0x0000000C (0000ms, 0946ms total)
T217C 001:347 JLINK_Go() (0003ms, 0949ms total)
T217C 001:350 JLINK_IsHalted() -- CPU_ReadMem(2 bytes @ 0x20000000)  returns TRUE (0005ms, 0954ms total)
T217C 001:355 JLINK_ReadReg(R15 (PC))  returns 0x20000000 (0000ms, 0949ms total)
T217C 001:355 JLINK_ClrBPEx(BPHandle = 0x0000000C)  returns 0x00 (0000ms, 0949ms total)
T217C 001:355 JLINK_ReadReg(R0)  returns 0x00000001 (0000ms, 0949ms total)
T217C 001:355 JLINK_WriteReg(R0, 0x00019400)  returns 0x00 (0000ms, 0949ms total)
T217C 001:355 JLINK_WriteReg(R1, 0x00000400)  returns 0x00 (0000ms, 0949ms total)
T217C 001:355 JLINK_WriteReg(R2, 0x000000FF)  returns 0x00 (0000ms, 0949ms total)
T217C 001:355 JLINK_WriteReg(R3, 0x00000000)  returns 0x00 (0000ms, 0949ms total)
T217C 001:355 JLINK_WriteReg(R4, 0x00000000)  returns 0x00 (0000ms, 0949ms total)
T217C 001:355 JLINK_WriteReg(R5, 0x00000000)  returns 0x00 (0000ms, 0949ms total)
T217C 001:355 JLINK_WriteReg(R6, 0x00000000)  returns 0x00 (0000ms, 0949ms total)
T217C 001:355 JLINK_WriteReg(R7, 0x00000000)  returns 0x00 (0000ms, 0949ms total)
T217C 001:355 JLINK_WriteReg(R8, 0x00000000)  returns 0x00 (0001ms, 0950ms total)
T217C 001:356 JLINK_WriteReg(R9, 0x2000046C)  returns 0x00 (0000ms, 0950ms total)
T217C 001:356 JLINK_WriteReg(R10, 0x00000000)  returns 0x00 (0000ms, 0950ms total)
T217C 001:356 JLINK_WriteReg(R11, 0x00000000)  returns 0x00 (0000ms, 0950ms total)
T217C 001:356 JLINK_WriteReg(R12, 0x00000000)  returns 0x00 (0000ms, 0950ms total)
T217C 001:356 JLINK_WriteReg(R13 (SP), 0x20001000)  returns 0x00 (0000ms, 0950ms total)
T217C 001:356 JLINK_WriteReg(R14, 0x20000001)  returns 0x00 (0000ms, 0950ms total)
T217C 001:356 JLINK_WriteReg(R15 (PC), 0x200000FE)  returns 0x00 (0000ms, 0950ms total)
T217C 001:356 JLINK_WriteReg(XPSR, 0x01000000)  returns 0x00 (0000ms, 0950ms total)
T217C 001:356 JLINK_WriteReg(MSP, 0x20001000)  returns 0x00 (0000ms, 0950ms total)
T217C 001:356 JLINK_WriteReg(PSP, 0x20001000)  returns 0x00 (0000ms, 0950ms total)
T217C 001:356 JLINK_WriteReg(CFBP, 0x00000000)  returns 0x00 (0000ms, 0950ms total)
T217C 001:356 JLINK_SetBPEx(Addr = 0x20000000, Type = 0xFFFFFFF2)  returns 0x0000000D (0000ms, 0950ms total)
T217C 001:356 JLINK_Go() (0002ms, 0952ms total)
T217C 001:358 JLINK_IsHalted()  returns FALSE (0001ms, 0953ms total)
T217C 001:361 JLINK_IsHalted()  returns FALSE (0001ms, 0953ms total)
T217C 001:364 JLINK_IsHalted()  returns FALSE (0001ms, 0953ms total)
T217C 001:367 JLINK_IsHalted()  returns FALSE (0001ms, 0953ms total)
T217C 001:370 JLINK_IsHalted()  returns FALSE (0001ms, 0953ms total)
T217C 001:373 JLINK_IsHalted()  returns FALSE (0001ms, 0953ms total)
T217C 001:378 JLINK_IsHalted()  returns FALSE (0001ms, 0953ms total)
T217C 001:381 JLINK_IsHalted() -- CPU_ReadMem(2 bytes @ 0x20000000)  returns TRUE (0005ms, 0957ms total)
T217C 001:386 JLINK_ReadReg(R15 (PC))  returns 0x20000000 (0000ms, 0952ms total)
T217C 001:386 JLINK_ClrBPEx(BPHandle = 0x0000000D)  returns 0x00 (0000ms, 0952ms total)
T217C 001:386 JLINK_ReadReg(R0)  returns 0x00000000 (0000ms, 0952ms total)
T217C 001:387 JLINK_WriteReg(R0, 0x00019800)  returns 0x00 (0000ms, 0952ms total)
T217C 001:387 JLINK_WriteReg(R1, 0x00000400)  returns 0x00 (0000ms, 0952ms total)
T217C 001:387 JLINK_WriteReg(R2, 0x000000FF)  returns 0x00 (0000ms, 0952ms total)
T217C 001:387 JLINK_WriteReg(R3, 0x00000000)  returns 0x00 (0000ms, 0952ms total)
T217C 001:387 JLINK_WriteReg(R4, 0x00000000)  returns 0x00 (0000ms, 0952ms total)
T217C 001:387 JLINK_WriteReg(R5, 0x00000000)  returns 0x00 (0000ms, 0952ms total)
T217C 001:387 JLINK_WriteReg(R6, 0x00000000)  returns 0x00 (0000ms, 0952ms total)
T217C 001:387 JLINK_WriteReg(R7, 0x00000000)  returns 0x00 (0000ms, 0952ms total)
T217C 001:387 JLINK_WriteReg(R8, 0x00000000)  returns 0x00 (0000ms, 0952ms total)
T217C 001:387 JLINK_WriteReg(R9, 0x2000046C)  returns 0x00 (0000ms, 0952ms total)
T217C 001:387 JLINK_WriteReg(R10, 0x00000000)  returns 0x00 (0000ms, 0952ms total)
T217C 001:387 JLINK_WriteReg(R11, 0x00000000)  returns 0x00 (0000ms, 0952ms total)
T217C 001:387 JLINK_WriteReg(R12, 0x00000000)  returns 0x00 (0000ms, 0952ms total)
T217C 001:387 JLINK_WriteReg(R13 (SP), 0x20001000)  returns 0x00 (0000ms, 0952ms total)
T217C 001:387 JLINK_WriteReg(R14, 0x20000001)  returns 0x00 (0001ms, 0953ms total)
T217C 001:388 JLINK_WriteReg(R15 (PC), 0x20000182)  returns 0x00 (0000ms, 0953ms total)
T217C 001:388 JLINK_WriteReg(XPSR, 0x01000000)  returns 0x00 (0000ms, 0953ms total)
T217C 001:388 JLINK_WriteReg(MSP, 0x20001000)  returns 0x00 (0000ms, 0953ms total)
T217C 001:388 JLINK_WriteReg(PSP, 0x20001000)  returns 0x00 (0000ms, 0953ms total)
T217C 001:388 JLINK_WriteReg(CFBP, 0x00000000)  returns 0x00 (0000ms, 0953ms total)
T217C 001:388 JLINK_SetBPEx(Addr = 0x20000000, Type = 0xFFFFFFF2)  returns 0x0000000E (0000ms, 0953ms total)
T217C 001:388 JLINK_Go() (0002ms, 0955ms total)
T217C 001:390 JLINK_IsHalted() -- CPU_ReadMem(2 bytes @ 0x20000000)  returns TRUE (0006ms, 0961ms total)
T217C 001:396 JLINK_ReadReg(R15 (PC))  returns 0x20000000 (0000ms, 0955ms total)
T217C 001:396 JLINK_ClrBPEx(BPHandle = 0x0000000E)  returns 0x00 (0000ms, 0955ms total)
T217C 001:396 JLINK_ReadReg(R0)  returns 0x00000001 (0000ms, 0955ms total)
T217C 001:396 JLINK_WriteReg(R0, 0x00019800)  returns 0x00 (0000ms, 0955ms total)
T217C 001:396 JLINK_WriteReg(R1, 0x00000400)  returns 0x00 (0000ms, 0955ms total)
T217C 001:396 JLINK_WriteReg(R2, 0x000000FF)  returns 0x00 (0000ms, 0955ms total)
T217C 001:396 JLINK_WriteReg(R3, 0x00000000)  returns 0x00 (0000ms, 0955ms total)
T217C 001:396 JLINK_WriteReg(R4, 0x00000000)  returns 0x00 (0000ms, 0955ms total)
T217C 001:396 JLINK_WriteReg(R5, 0x00000000)  returns 0x00 (0000ms, 0955ms total)
T217C 001:396 JLINK_WriteReg(R6, 0x00000000)  returns 0x00 (0000ms, 0955ms total)
T217C 001:396 JLINK_WriteReg(R7, 0x00000000)  returns 0x00 (0000ms, 0955ms total)
T217C 001:396 JLINK_WriteReg(R8, 0x00000000)  returns 0x00 (0000ms, 0955ms total)
T217C 001:396 JLINK_WriteReg(R9, 0x2000046C)  returns 0x00 (0001ms, 0956ms total)
T217C 001:397 JLINK_WriteReg(R10, 0x00000000)  returns 0x00 (0000ms, 0956ms total)
T217C 001:397 JLINK_WriteReg(R11, 0x00000000)  returns 0x00 (0000ms, 0956ms total)
T217C 001:397 JLINK_WriteReg(R12, 0x00000000)  returns 0x00 (0000ms, 0956ms total)
T217C 001:397 JLINK_WriteReg(R13 (SP), 0x20001000)  returns 0x00 (0000ms, 0956ms total)
T217C 001:397 JLINK_WriteReg(R14, 0x20000001)  returns 0x00 (0000ms, 0956ms total)
T217C 001:397 JLINK_WriteReg(R15 (PC), 0x200000FE)  returns 0x00 (0000ms, 0956ms total)
T217C 001:397 JLINK_WriteReg(XPSR, 0x01000000)  returns 0x00 (0000ms, 0956ms total)
T217C 001:397 JLINK_WriteReg(MSP, 0x20001000)  returns 0x00 (0000ms, 0956ms total)
T217C 001:397 JLINK_WriteReg(PSP, 0x20001000)  returns 0x00 (0000ms, 0956ms total)
T217C 001:397 JLINK_WriteReg(CFBP, 0x00000000)  returns 0x00 (0000ms, 0956ms total)
T217C 001:397 JLINK_SetBPEx(Addr = 0x20000000, Type = 0xFFFFFFF2)  returns 0x0000000F (0000ms, 0956ms total)
T217C 001:397 JLINK_Go() (0002ms, 0958ms total)
T217C 001:399 JLINK_IsHalted()  returns FALSE (0001ms, 0959ms total)
T217C 001:402 JLINK_IsHalted()  returns FALSE (0000ms, 0958ms total)
T217C 001:405 JLINK_IsHalted()  returns FALSE (0001ms, 0959ms total)
T217C 001:408 JLINK_IsHalted()  returns FALSE (0000ms, 0958ms total)
T217C 001:410 JLINK_IsHalted()  returns FALSE (0000ms, 0958ms total)
T217C 001:413 JLINK_IsHalted()  returns FALSE (0000ms, 0958ms total)
T217C 001:416 JLINK_IsHalted()  returns FALSE (0000ms, 0958ms total)
T217C 001:419 JLINK_IsHalted()  returns FALSE (0000ms, 0958ms total)
T217C 001:426 JLINK_IsHalted() -- CPU_ReadMem(2 bytes @ 0x20000000)  returns TRUE (0005ms, 0963ms total)
T217C 001:431 JLINK_ReadReg(R15 (PC))  returns 0x20000000 (0000ms, 0958ms total)
T217C 001:431 JLINK_ClrBPEx(BPHandle = 0x0000000F)  returns 0x00 (0000ms, 0958ms total)
T217C 001:431 JLINK_ReadReg(R0)  returns 0x00000000 (0000ms, 0958ms total)
T217C 001:432 JLINK_WriteReg(R0, 0x00000001)  returns 0x00 (0000ms, 0958ms total)
T217C 001:432 JLINK_WriteReg(R1, 0x00000400)  returns 0x00 (0000ms, 0958ms total)
T217C 001:432 JLINK_WriteReg(R2, 0x000000FF)  returns 0x00 (0000ms, 0958ms total)
T217C 001:432 JLINK_WriteReg(R3, 0x00000000)  returns 0x00 (0000ms, 0958ms total)
T217C 001:432 JLINK_WriteReg(R4, 0x00000000)  returns 0x00 (0000ms, 0958ms total)
T217C 001:432 JLINK_WriteReg(R5, 0x00000000)  returns 0x00 (0000ms, 0958ms total)
T217C 001:432 JLINK_WriteReg(R6, 0x00000000)  returns 0x00 (0000ms, 0958ms total)
T217C 001:432 JLINK_WriteReg(R7, 0x00000000)  returns 0x00 (0000ms, 0958ms total)
T217C 001:432 JLINK_WriteReg(R8, 0x00000000)  returns 0x00 (0000ms, 0958ms total)
T217C 001:432 JLINK_WriteReg(R9, 0x2000046C)  returns 0x00 (0000ms, 0958ms total)
T217C 001:432 JLINK_WriteReg(R10, 0x00000000)  returns 0x00 (0000ms, 0958ms total)
T217C 001:432 JLINK_WriteReg(R11, 0x00000000)  returns 0x00 (0000ms, 0958ms total)
T217C 001:432 JLINK_WriteReg(R12, 0x00000000)  returns 0x00 (0000ms, 0958ms total)
T217C 001:432 JLINK_WriteReg(R13 (SP), 0x20001000)  returns 0x00 (0000ms, 0958ms total)
T217C 001:432 JLINK_WriteReg(R14, 0x20000001)  returns 0x00 (0000ms, 0958ms total)
T217C 001:432 JLINK_WriteReg(R15 (PC), 0x20000052)  returns 0x00 (0000ms, 0958ms total)
T217C 001:432 JLINK_WriteReg(XPSR, 0x01000000)  returns 0x00 (0000ms, 0958ms total)
T217C 001:432 JLINK_WriteReg(MSP, 0x20001000)  returns 0x00 (0000ms, 0958ms total)
T217C 001:432 JLINK_WriteReg(PSP, 0x20001000)  returns 0x00 (0000ms, 0958ms total)
T217C 001:432 JLINK_WriteReg(CFBP, 0x00000000)  returns 0x00 (0000ms, 0958ms total)
T217C 001:432 JLINK_SetBPEx(Addr = 0x20000000, Type = 0xFFFFFFF2)  returns 0x00000010 (0000ms, 0958ms total)
T217C 001:432 JLINK_Go() (0003ms, 0961ms total)
T217C 001:435 JLINK_IsHalted() -- CPU_ReadMem(2 bytes @ 0x20000000)  returns TRUE (0006ms, 0967ms total)
T217C 001:441 JLINK_ReadReg(R15 (PC))  returns 0x20000000 (0000ms, 0961ms total)
T217C 001:441 JLINK_ClrBPEx(BPHandle = 0x00000010)  returns 0x00 (0000ms, 0961ms total)
T217C 001:441 JLINK_ReadReg(R0)  returns 0x00000000 (0000ms, 0961ms total)
T217C 001:502 JLINK_WriteMem(0x20000000, 0x0470 Bytes, ...) - Data: 00 BE 0A E0 0D 78 2D 06 68 40 08 24 40 00 00 D3 ... -- CPU_WriteMem(1136 bytes @ 0x20000000)  returns 0x470 (0017ms, 0978ms total)
T217C 001:519 JLINK_WriteReg(R0, 0x00000000)  returns 0x00 (0000ms, 0978ms total)
T217C 001:519 JLINK_WriteReg(R1, 0x00F42400)  returns 0x00 (0000ms, 0978ms total)
T217C 001:519 JLINK_WriteReg(R2, 0x00000002)  returns 0x00 (0000ms, 0978ms total)
T217C 001:519 JLINK_WriteReg(R3, 0x00000000)  returns 0x00 (0000ms, 0978ms total)
T217C 001:519 JLINK_WriteReg(R4, 0x00000000)  returns 0x00 (0000ms, 0978ms total)
T217C 001:519 JLINK_WriteReg(R5, 0x00000000)  returns 0x00 (0000ms, 0978ms total)
T217C 001:519 JLINK_WriteReg(R6, 0x00000000)  returns 0x00 (0000ms, 0978ms total)
T217C 001:519 JLINK_WriteReg(R7, 0x00000000)  returns 0x00 (0000ms, 0978ms total)
T217C 001:519 JLINK_WriteReg(R8, 0x00000000)  returns 0x00 (0000ms, 0978ms total)
T217C 001:519 JLINK_WriteReg(R9, 0x2000046C)  returns 0x00 (0000ms, 0978ms total)
T217C 001:519 JLINK_WriteReg(R10, 0x00000000)  returns 0x00 (0000ms, 0978ms total)
T217C 001:519 JLINK_WriteReg(R11, 0x00000000)  returns 0x00 (0000ms, 0978ms total)
T217C 001:519 JLINK_WriteReg(R12, 0x00000000)  returns 0x00 (0000ms, 0978ms total)
T217C 001:519 JLINK_WriteReg(R13 (SP), 0x20001000)  returns 0x00 (0000ms, 0978ms total)
T217C 001:519 JLINK_WriteReg(R14, 0x20000001)  returns 0x00 (0001ms, 0979ms total)
T217C 001:520 JLINK_WriteReg(R15 (PC), 0x20000028)  returns 0x00 (0000ms, 0979ms total)
T217C 001:520 JLINK_WriteReg(XPSR, 0x01000000)  returns 0x00 (0000ms, 0979ms total)
T217C 001:520 JLINK_WriteReg(MSP, 0x20001000)  returns 0x00 (0000ms, 0979ms total)
T217C 001:520 JLINK_WriteReg(PSP, 0x20001000)  returns 0x00 (0000ms, 0979ms total)
T217C 001:520 JLINK_WriteReg(CFBP, 0x00000000)  returns 0x00 (0000ms, 0979ms total)
T217C 001:520 JLINK_SetBPEx(Addr = 0x20000000, Type = 0xFFFFFFF2) -- CPU_ReadMem(2 bytes @ 0x20000000)  returns 0x00000011 (0001ms, 0980ms total)
T217C 001:521 JLINK_Go() -- CPU_WriteMem(2 bytes @ 0x20000000) (0003ms, 0983ms total)
T217C 001:524 JLINK_IsHalted() -- CPU_ReadMem(2 bytes @ 0x20000000)  returns TRUE (0006ms, 0989ms total)
T217C 001:530 JLINK_ReadReg(R15 (PC))  returns 0x20000000 (0000ms, 0983ms total)
T217C 001:530 JLINK_ClrBPEx(BPHandle = 0x00000011)  returns 0x00 (0000ms, 0983ms total)
T217C 001:530 JLINK_ReadReg(R0)  returns 0x00000000 (0000ms, 0983ms total)
T217C 001:531 JLINK_WriteMem(0x20000470, 0x0390 Bytes, ...) - Data: 00 2C 00 20 F5 80 01 00 0F 81 01 00 11 81 01 00 ... -- CPU_WriteMem(912 bytes @ 0x20000470)  returns 0x390 (0013ms, 0996ms total)
T217C 001:544 JLINK_WriteMem(0x20000800, 0x0070 Bytes, ...) - Data: 01 91 00 90 05 9B 04 9A 07 99 06 98 00 F0 E9 F8 ... -- CPU_WriteMem(112 bytes @ 0x20000800)  returns 0x70 (0002ms, 0998ms total)
T217C 001:546 JLINK_WriteReg(R0, 0x00018000)  returns 0x00 (0000ms, 0998ms total)
T217C 001:546 JLINK_WriteReg(R1, 0x00000400)  returns 0x00 (0000ms, 0998ms total)
T217C 001:546 JLINK_WriteReg(R2, 0x20000470)  returns 0x00 (0000ms, 0998ms total)
T217C 001:546 JLINK_WriteReg(R3, 0x00000000)  returns 0x00 (0000ms, 0998ms total)
T217C 001:546 JLINK_WriteReg(R4, 0x00000000)  returns 0x00 (0000ms, 0998ms total)
T217C 001:546 JLINK_WriteReg(R5, 0x00000000)  returns 0x00 (0000ms, 0998ms total)
T217C 001:546 JLINK_WriteReg(R6, 0x00000000)  returns 0x00 (0000ms, 0998ms total)
T217C 001:546 JLINK_WriteReg(R7, 0x00000000)  returns 0x00 (0001ms, 0999ms total)
T217C 001:547 JLINK_WriteReg(R8, 0x00000000)  returns 0x00 (0000ms, 0999ms total)
T217C 001:547 JLINK_WriteReg(R9, 0x2000046C)  returns 0x00 (0000ms, 0999ms total)
T217C 001:547 JLINK_WriteReg(R10, 0x00000000)  returns 0x00 (0000ms, 0999ms total)
T217C 001:547 JLINK_WriteReg(R11, 0x00000000)  returns 0x00 (0000ms, 0999ms total)
T217C 001:547 JLINK_WriteReg(R12, 0x00000000)  returns 0x00 (0000ms, 0999ms total)
T217C 001:547 JLINK_WriteReg(R13 (SP), 0x20001000)  returns 0x00 (0000ms, 0999ms total)
T217C 001:547 JLINK_WriteReg(R14, 0x20000001)  returns 0x00 (0000ms, 0999ms total)
T217C 001:547 JLINK_WriteReg(R15 (PC), 0x200001BE)  returns 0x00 (0000ms, 0999ms total)
T217C 001:547 JLINK_WriteReg(XPSR, 0x01000000)  returns 0x00 (0000ms, 0999ms total)
T217C 001:547 JLINK_WriteReg(MSP, 0x20001000)  returns 0x00 (0000ms, 0999ms total)
T217C 001:547 JLINK_WriteReg(PSP, 0x20001000)  returns 0x00 (0000ms, 0999ms total)
T217C 001:547 JLINK_WriteReg(CFBP, 0x00000000)  returns 0x00 (0000ms, 0999ms total)
T217C 001:547 JLINK_SetBPEx(Addr = 0x20000000, Type = 0xFFFFFFF2)  returns 0x00000012 (0000ms, 0999ms total)
T217C 001:547 JLINK_Go() (0003ms, 1002ms total)
T217C 001:550 JLINK_IsHalted()  returns FALSE (0001ms, 1003ms total)
T217C 001:564 JLINK_IsHalted() -- CPU_ReadMem(2 bytes @ 0x20000000)  returns TRUE (0006ms, 1008ms total)
T217C 001:570 JLINK_ReadReg(R15 (PC))  returns 0x20000000 (0000ms, 1002ms total)
T217C 001:570 JLINK_ClrBPEx(BPHandle = 0x00000012)  returns 0x00 (0000ms, 1002ms total)
T217C 001:570 JLINK_ReadReg(R0)  returns 0x00000000 (0000ms, 1002ms total)
T217C 001:570 JLINK_WriteMem(0x20000470, 0x0390 Bytes, ...) - Data: 00 90 02 E0 92 18 00 98 5B 41 00 28 03 DA 00 20 ... -- CPU_WriteMem(912 bytes @ 0x20000470)  returns 0x390 (0013ms, 1015ms total)
T217C 001:583 JLINK_WriteMem(0x20000800, 0x0070 Bytes, ...) - Data: 18 D0 A5 60 19 48 80 69 C1 B2 19 48 00 F0 A9 F9 ... -- CPU_WriteMem(112 bytes @ 0x20000800)  returns 0x70 (0003ms, 1018ms total)
T217C 001:586 JLINK_WriteReg(R0, 0x00018400)  returns 0x00 (0000ms, 1018ms total)
T217C 001:586 JLINK_WriteReg(R1, 0x00000400)  returns 0x00 (0000ms, 1018ms total)
T217C 001:586 JLINK_WriteReg(R2, 0x20000470)  returns 0x00 (0000ms, 1018ms total)
T217C 001:586 JLINK_WriteReg(R3, 0x00000000)  returns 0x00 (0000ms, 1018ms total)
T217C 001:586 JLINK_WriteReg(R4, 0x00000000)  returns 0x00 (0000ms, 1018ms total)
T217C 001:586 JLINK_WriteReg(R5, 0x00000000)  returns 0x00 (0000ms, 1018ms total)
T217C 001:586 JLINK_WriteReg(R6, 0x00000000)  returns 0x00 (0000ms, 1018ms total)
T217C 001:586 JLINK_WriteReg(R7, 0x00000000)  returns 0x00 (0000ms, 1018ms total)
T217C 001:586 JLINK_WriteReg(R8, 0x00000000)  returns 0x00 (0000ms, 1018ms total)
T217C 001:586 JLINK_WriteReg(R9, 0x2000046C)  returns 0x00 (0000ms, 1018ms total)
T217C 001:586 JLINK_WriteReg(R10, 0x00000000)  returns 0x00 (0000ms, 1018ms total)
T217C 001:586 JLINK_WriteReg(R11, 0x00000000)  returns 0x00 (0000ms, 1018ms total)
T217C 001:586 JLINK_WriteReg(R12, 0x00000000)  returns 0x00 (0000ms, 1018ms total)
T217C 001:586 JLINK_WriteReg(R13 (SP), 0x20001000)  returns 0x00 (0000ms, 1018ms total)
T217C 001:586 JLINK_WriteReg(R14, 0x20000001)  returns 0x00 (0000ms, 1018ms total)
T217C 001:586 JLINK_WriteReg(R15 (PC), 0x200001BE)  returns 0x00 (0000ms, 1018ms total)
T217C 001:586 JLINK_WriteReg(XPSR, 0x01000000)  returns 0x00 (0000ms, 1018ms total)
T217C 001:586 JLINK_WriteReg(MSP, 0x20001000)  returns 0x00 (0000ms, 1018ms total)
T217C 001:586 JLINK_WriteReg(PSP, 0x20001000)  returns 0x00 (0000ms, 1018ms total)
T217C 001:586 JLINK_WriteReg(CFBP, 0x00000000)  returns 0x00 (0000ms, 1018ms total)
T217C 001:586 JLINK_SetBPEx(Addr = 0x20000000, Type = 0xFFFFFFF2)  returns 0x00000013 (0000ms, 1018ms total)
T217C 001:586 JLINK_Go() (0003ms, 1021ms total)
T217C 001:589 JLINK_IsHalted()  returns FALSE (0001ms, 1022ms total)
T217C 001:592 JLINK_IsHalted()  returns FALSE (0001ms, 1022ms total)
T217C 001:595 JLINK_IsHalted()  returns FALSE (0001ms, 1022ms total)
T217C 001:598 JLINK_IsHalted()  returns FALSE (0001ms, 1022ms total)
T217C 001:601 JLINK_IsHalted() -- CPU_ReadMem(2 bytes @ 0x20000000)  returns TRUE (0005ms, 1026ms total)
T217C 001:606 JLINK_ReadReg(R15 (PC))  returns 0x20000000 (0000ms, 1021ms total)
T217C 001:606 JLINK_ClrBPEx(BPHandle = 0x00000013)  returns 0x00 (0000ms, 1021ms total)
T217C 001:606 JLINK_ReadReg(R0)  returns 0x00000000 (0000ms, 1021ms total)
T217C 001:607 JLINK_WriteMem(0x20000470, 0x0390 Bytes, ...) - Data: DC 23 00 20 20 21 02 0C 01 D0 10 21 10 46 02 0A ... -- CPU_WriteMem(912 bytes @ 0x20000470)  returns 0x390 (0013ms, 1034ms total)
T217C 001:620 JLINK_WriteMem(0x20000800, 0x0070 Bytes, ...) - Data: 24 23 43 43 D4 54 9B 18 1C 75 40 1C B8 42 F7 DB ... -- CPU_WriteMem(112 bytes @ 0x20000800)  returns 0x70 (0002ms, 1036ms total)
T217C 001:622 JLINK_WriteReg(R0, 0x00018800)  returns 0x00 (0000ms, 1036ms total)
T217C 001:622 JLINK_WriteReg(R1, 0x00000400)  returns 0x00 (0000ms, 1036ms total)
T217C 001:622 JLINK_WriteReg(R2, 0x20000470)  returns 0x00 (0000ms, 1036ms total)
T217C 001:622 JLINK_WriteReg(R3, 0x00000000)  returns 0x00 (0000ms, 1036ms total)
T217C 001:622 JLINK_WriteReg(R4, 0x00000000)  returns 0x00 (0000ms, 1036ms total)
T217C 001:622 JLINK_WriteReg(R5, 0x00000000)  returns 0x00 (0000ms, 1036ms total)
T217C 001:622 JLINK_WriteReg(R6, 0x00000000)  returns 0x00 (0000ms, 1036ms total)
T217C 001:622 JLINK_WriteReg(R7, 0x00000000)  returns 0x00 (0000ms, 1036ms total)
T217C 001:622 JLINK_WriteReg(R8, 0x00000000)  returns 0x00 (0001ms, 1037ms total)
T217C 001:623 JLINK_WriteReg(R9, 0x2000046C)  returns 0x00 (0000ms, 1037ms total)
T217C 001:623 JLINK_WriteReg(R10, 0x00000000)  returns 0x00 (0000ms, 1037ms total)
T217C 001:623 JLINK_WriteReg(R11, 0x00000000)  returns 0x00 (0000ms, 1037ms total)
T217C 001:623 JLINK_WriteReg(R12, 0x00000000)  returns 0x00 (0000ms, 1037ms total)
T217C 001:623 JLINK_WriteReg(R13 (SP), 0x20001000)  returns 0x00 (0000ms, 1037ms total)
T217C 001:623 JLINK_WriteReg(R14, 0x20000001)  returns 0x00 (0000ms, 1037ms total)
T217C 001:623 JLINK_WriteReg(R15 (PC), 0x200001BE)  returns 0x00 (0000ms, 1037ms total)
T217C 001:623 JLINK_WriteReg(XPSR, 0x01000000)  returns 0x00 (0000ms, 1037ms total)
T217C 001:623 JLINK_WriteReg(MSP, 0x20001000)  returns 0x00 (0000ms, 1037ms total)
T217C 001:623 JLINK_WriteReg(PSP, 0x20001000)  returns 0x00 (0000ms, 1037ms total)
T217C 001:623 JLINK_WriteReg(CFBP, 0x00000000)  returns 0x00 (0000ms, 1037ms total)
T217C 001:623 JLINK_SetBPEx(Addr = 0x20000000, Type = 0xFFFFFFF2)  returns 0x00000014 (0000ms, 1037ms total)
T217C 001:623 JLINK_Go() (0003ms, 1040ms total)
T217C 001:626 JLINK_IsHalted()  returns FALSE (0001ms, 1041ms total)
T217C 001:629 JLINK_IsHalted()  returns FALSE (0001ms, 1041ms total)
T217C 001:632 JLINK_IsHalted()  returns FALSE (0001ms, 1041ms total)
T217C 001:635 JLINK_IsHalted()  returns FALSE (0001ms, 1041ms total)
T217C 001:640 JLINK_IsHalted() -- CPU_ReadMem(2 bytes @ 0x20000000)  returns TRUE (0006ms, 1046ms total)
T217C 001:646 JLINK_ReadReg(R15 (PC))  returns 0x20000000 (0000ms, 1040ms total)
T217C 001:646 JLINK_ClrBPEx(BPHandle = 0x00000014)  returns 0x00 (0000ms, 1040ms total)
T217C 001:646 JLINK_ReadReg(R0)  returns 0x00000000 (0000ms, 1040ms total)
T217C 001:646 JLINK_WriteMem(0x20000470, 0x0390 Bytes, ...) - Data: 00 20 C3 E7 30 20 00 20 80 E2 00 E0 00 E1 00 E0 ... -- CPU_WriteMem(912 bytes @ 0x20000470)  returns 0x390 (0014ms, 1054ms total)
T217C 001:660 JLINK_WriteMem(0x20000800, 0x0070 Bytes, ...) - Data: 00 65 00 40 00 20 00 20 00 05 00 50 40 A0 00 40 ... -- CPU_WriteMem(112 bytes @ 0x20000800)  returns 0x70 (0002ms, 1056ms total)
T217C 001:662 JLINK_WriteReg(R0, 0x00018C00)  returns 0x00 (0000ms, 1056ms total)
T217C 001:662 JLINK_WriteReg(R1, 0x00000400)  returns 0x00 (0000ms, 1056ms total)
T217C 001:662 JLINK_WriteReg(R2, 0x20000470)  returns 0x00 (0000ms, 1056ms total)
T217C 001:662 JLINK_WriteReg(R3, 0x00000000)  returns 0x00 (0000ms, 1056ms total)
T217C 001:662 JLINK_WriteReg(R4, 0x00000000)  returns 0x00 (0000ms, 1056ms total)
T217C 001:662 JLINK_WriteReg(R5, 0x00000000)  returns 0x00 (0000ms, 1056ms total)
T217C 001:662 JLINK_WriteReg(R6, 0x00000000)  returns 0x00 (0000ms, 1056ms total)
T217C 001:662 JLINK_WriteReg(R7, 0x00000000)  returns 0x00 (0000ms, 1056ms total)
T217C 001:662 JLINK_WriteReg(R8, 0x00000000)  returns 0x00 (0000ms, 1056ms total)
T217C 001:662 JLINK_WriteReg(R9, 0x2000046C)  returns 0x00 (0000ms, 1056ms total)
T217C 001:662 JLINK_WriteReg(R10, 0x00000000)  returns 0x00 (0001ms, 1057ms total)
T217C 001:663 JLINK_WriteReg(R11, 0x00000000)  returns 0x00 (0000ms, 1057ms total)
T217C 001:663 JLINK_WriteReg(R12, 0x00000000)  returns 0x00 (0000ms, 1057ms total)
T217C 001:663 JLINK_WriteReg(R13 (SP), 0x20001000)  returns 0x00 (0000ms, 1057ms total)
T217C 001:663 JLINK_WriteReg(R14, 0x20000001)  returns 0x00 (0000ms, 1057ms total)
T217C 001:663 JLINK_WriteReg(R15 (PC), 0x200001BE)  returns 0x00 (0000ms, 1057ms total)
T217C 001:663 JLINK_WriteReg(XPSR, 0x01000000)  returns 0x00 (0000ms, 1057ms total)
T217C 001:663 JLINK_WriteReg(MSP, 0x20001000)  returns 0x00 (0000ms, 1057ms total)
T217C 001:663 JLINK_WriteReg(PSP, 0x20001000)  returns 0x00 (0000ms, 1057ms total)
T217C 001:663 JLINK_WriteReg(CFBP, 0x00000000)  returns 0x00 (0000ms, 1057ms total)
T217C 001:663 JLINK_SetBPEx(Addr = 0x20000000, Type = 0xFFFFFFF2)  returns 0x00000015 (0000ms, 1057ms total)
T217C 001:663 JLINK_Go() (0003ms, 1060ms total)
T217C 001:666 JLINK_IsHalted()  returns FALSE (0001ms, 1061ms total)
T217C 001:671 JLINK_IsHalted()  returns FALSE (0001ms, 1061ms total)
T217C 001:674 JLINK_IsHalted()  returns FALSE (0001ms, 1061ms total)
T217C 001:677 JLINK_IsHalted() -- CPU_ReadMem(2 bytes @ 0x20000000)  returns TRUE (0006ms, 1066ms total)
T217C 001:683 JLINK_ReadReg(R15 (PC))  returns 0x20000000 (0000ms, 1060ms total)
T217C 001:683 JLINK_ClrBPEx(BPHandle = 0x00000015)  returns 0x00 (0000ms, 1060ms total)
T217C 001:683 JLINK_ReadReg(R0)  returns 0x00000000 (0000ms, 1060ms total)
T217C 001:683 JLINK_WriteMem(0x20000470, 0x0390 Bytes, ...) - Data: 04 D0 13 E0 01 26 F6 E7 01 25 F8 E7 68 46 51 DF ... -- CPU_WriteMem(912 bytes @ 0x20000470)  returns 0x390 (0014ms, 1074ms total)
T217C 001:697 JLINK_WriteMem(0x20000800, 0x0070 Bytes, ...) - Data: 64 1C E2 B2 B1 54 29 78 80 1C 08 18 28 70 00 20 ... -- CPU_WriteMem(112 bytes @ 0x20000800)  returns 0x70 (0002ms, 1076ms total)
T217C 001:699 JLINK_WriteReg(R0, 0x00019000)  returns 0x00 (0000ms, 1076ms total)
T217C 001:699 JLINK_WriteReg(R1, 0x00000400)  returns 0x00 (0000ms, 1076ms total)
T217C 001:699 JLINK_WriteReg(R2, 0x20000470)  returns 0x00 (0000ms, 1076ms total)
T217C 001:699 JLINK_WriteReg(R3, 0x00000000)  returns 0x00 (0000ms, 1076ms total)
T217C 001:699 JLINK_WriteReg(R4, 0x00000000)  returns 0x00 (0000ms, 1076ms total)
T217C 001:699 JLINK_WriteReg(R5, 0x00000000)  returns 0x00 (0000ms, 1076ms total)
T217C 001:699 JLINK_WriteReg(R6, 0x00000000)  returns 0x00 (0000ms, 1076ms total)
T217C 001:699 JLINK_WriteReg(R7, 0x00000000)  returns 0x00 (0000ms, 1076ms total)
T217C 001:699 JLINK_WriteReg(R8, 0x00000000)  returns 0x00 (0000ms, 1076ms total)
T217C 001:699 JLINK_WriteReg(R9, 0x2000046C)  returns 0x00 (0000ms, 1076ms total)
T217C 001:699 JLINK_WriteReg(R10, 0x00000000)  returns 0x00 (0001ms, 1077ms total)
T217C 001:700 JLINK_WriteReg(R11, 0x00000000)  returns 0x00 (0000ms, 1077ms total)
T217C 001:700 JLINK_WriteReg(R12, 0x00000000)  returns 0x00 (0000ms, 1077ms total)
T217C 001:700 JLINK_WriteReg(R13 (SP), 0x20001000)  returns 0x00 (0000ms, 1077ms total)
T217C 001:700 JLINK_WriteReg(R14, 0x20000001)  returns 0x00 (0000ms, 1077ms total)
T217C 001:700 JLINK_WriteReg(R15 (PC), 0x200001BE)  returns 0x00 (0000ms, 1077ms total)
T217C 001:700 JLINK_WriteReg(XPSR, 0x01000000)  returns 0x00 (0000ms, 1077ms total)
T217C 001:700 JLINK_WriteReg(MSP, 0x20001000)  returns 0x00 (0000ms, 1077ms total)
T217C 001:700 JLINK_WriteReg(PSP, 0x20001000)  returns 0x00 (0000ms, 1077ms total)
T217C 001:700 JLINK_WriteReg(CFBP, 0x00000000)  returns 0x00 (0000ms, 1077ms total)
T217C 001:700 JLINK_SetBPEx(Addr = 0x20000000, Type = 0xFFFFFFF2)  returns 0x00000016 (0000ms, 1077ms total)
T217C 001:700 JLINK_Go() (0003ms, 1080ms total)
T217C 001:703 JLINK_IsHalted()  returns FALSE (0001ms, 1081ms total)
T217C 001:706 JLINK_IsHalted()  returns FALSE (0001ms, 1081ms total)
T217C 001:709 JLINK_IsHalted()  returns FALSE (0001ms, 1081ms total)
T217C 001:712 JLINK_IsHalted()  returns FALSE (0001ms, 1081ms total)
T217C 001:715 JLINK_IsHalted() -- CPU_ReadMem(2 bytes @ 0x20000000)  returns TRUE (0006ms, 1086ms total)
T217C 001:721 JLINK_ReadReg(R15 (PC))  returns 0x20000000 (0000ms, 1080ms total)
T217C 001:721 JLINK_ClrBPEx(BPHandle = 0x00000016)  returns 0x00 (0000ms, 1080ms total)
T217C 001:721 JLINK_ReadReg(R0)  returns 0x00000000 (0000ms, 1080ms total)
T217C 001:721 JLINK_WriteMem(0x20000470, 0x0390 Bytes, ...) - Data: 03 28 01 D1 02 20 48 70 10 BD 13 4B 04 20 18 60 ... -- CPU_WriteMem(912 bytes @ 0x20000470)  returns 0x390 (0014ms, 1094ms total)
T217C 001:735 JLINK_WriteMem(0x20000800, 0x0070 Bytes, ...) - Data: 70 47 00 00 12 49 48 68 C0 05 C0 0D 19 D0 10 38 ... -- CPU_WriteMem(112 bytes @ 0x20000800)  returns 0x70 (0003ms, 1097ms total)
T217C 001:738 JLINK_WriteReg(R0, 0x00019400)  returns 0x00 (0000ms, 1097ms total)
T217C 001:738 JLINK_WriteReg(R1, 0x00000400)  returns 0x00 (0000ms, 1097ms total)
T217C 001:738 JLINK_WriteReg(R2, 0x20000470)  returns 0x00 (0000ms, 1097ms total)
T217C 001:738 JLINK_WriteReg(R3, 0x00000000)  returns 0x00 (0000ms, 1097ms total)
T217C 001:738 JLINK_WriteReg(R4, 0x00000000)  returns 0x00 (0000ms, 1097ms total)
T217C 001:738 JLINK_WriteReg(R5, 0x00000000)  returns 0x00 (0000ms, 1097ms total)
T217C 001:738 JLINK_WriteReg(R6, 0x00000000)  returns 0x00 (0000ms, 1097ms total)
T217C 001:738 JLINK_WriteReg(R7, 0x00000000)  returns 0x00 (0000ms, 1097ms total)
T217C 001:738 JLINK_WriteReg(R8, 0x00000000)  returns 0x00 (0000ms, 1097ms total)
T217C 001:738 JLINK_WriteReg(R9, 0x2000046C)  returns 0x00 (0000ms, 1097ms total)
T217C 001:738 JLINK_WriteReg(R10, 0x00000000)  returns 0x00 (0000ms, 1097ms total)
T217C 001:738 JLINK_WriteReg(R11, 0x00000000)  returns 0x00 (0000ms, 1097ms total)
T217C 001:738 JLINK_WriteReg(R12, 0x00000000)  returns 0x00 (0000ms, 1097ms total)
T217C 001:738 JLINK_WriteReg(R13 (SP), 0x20001000)  returns 0x00 (0000ms, 1097ms total)
T217C 001:738 JLINK_WriteReg(R14, 0x20000001)  returns 0x00 (0000ms, 1097ms total)
T217C 001:738 JLINK_WriteReg(R15 (PC), 0x200001BE)  returns 0x00 (0000ms, 1097ms total)
T217C 001:738 JLINK_WriteReg(XPSR, 0x01000000)  returns 0x00 (0000ms, 1097ms total)
T217C 001:738 JLINK_WriteReg(MSP, 0x20001000)  returns 0x00 (0000ms, 1097ms total)
T217C 001:739 JLINK_WriteReg(PSP, 0x20001000)  returns 0x00 (0000ms, 1098ms total)
T217C 001:739 JLINK_WriteReg(CFBP, 0x00000000)  returns 0x00 (0000ms, 1098ms total)
T217C 001:739 JLINK_SetBPEx(Addr = 0x20000000, Type = 0xFFFFFFF2)  returns 0x00000017 (0000ms, 1098ms total)
T217C 001:739 JLINK_Go() (0002ms, 1100ms total)
T217C 001:742 JLINK_IsHalted()  returns FALSE (0000ms, 1100ms total)
T217C 001:744 JLINK_IsHalted()  returns FALSE (0001ms, 1101ms total)
T217C 001:749 JLINK_IsHalted()  returns FALSE (0001ms, 1101ms total)
T217C 001:752 JLINK_IsHalted()  returns FALSE (0001ms, 1101ms total)
T217C 001:755 JLINK_IsHalted() -- CPU_ReadMem(2 bytes @ 0x20000000)  returns TRUE (0005ms, 1105ms total)
T217C 001:760 JLINK_ReadReg(R15 (PC))  returns 0x20000000 (0000ms, 1100ms total)
T217C 001:760 JLINK_ClrBPEx(BPHandle = 0x00000017)  returns 0x00 (0000ms, 1100ms total)
T217C 001:760 JLINK_ReadReg(R0)  returns 0x00000000 (0000ms, 1100ms total)
T217C 001:761 JLINK_WriteMem(0x20000470, 0x0390 Bytes, ...) - Data: 41 68 40 78 18 22 50 43 08 18 70 47 F8 B5 15 46 ... -- CPU_WriteMem(912 bytes @ 0x20000470)  returns 0x390 (0013ms, 1113ms total)
T217C 001:774 JLINK_WriteMem(0x20000800, 0x0070 Bytes, ...) - Data: FF FF FF FF FF FF FF FF FF FF FF FF FF FF FF FF ... -- CPU_WriteMem(112 bytes @ 0x20000800)  returns 0x70 (0003ms, 1116ms total)
T217C 001:777 JLINK_WriteReg(R0, 0x00019800)  returns 0x00 (0000ms, 1116ms total)
T217C 001:777 JLINK_WriteReg(R1, 0x0000015C)  returns 0x00 (0000ms, 1116ms total)
T217C 001:777 JLINK_WriteReg(R2, 0x20000470)  returns 0x00 (0000ms, 1116ms total)
T217C 001:777 JLINK_WriteReg(R3, 0x00000000)  returns 0x00 (0000ms, 1116ms total)
T217C 001:777 JLINK_WriteReg(R4, 0x00000000)  returns 0x00 (0000ms, 1116ms total)
T217C 001:777 JLINK_WriteReg(R5, 0x00000000)  returns 0x00 (0000ms, 1116ms total)
T217C 001:777 JLINK_WriteReg(R6, 0x00000000)  returns 0x00 (0000ms, 1116ms total)
T217C 001:777 JLINK_WriteReg(R7, 0x00000000)  returns 0x00 (0000ms, 1116ms total)
T217C 001:777 JLINK_WriteReg(R8, 0x00000000)  returns 0x00 (0000ms, 1116ms total)
T217C 001:777 JLINK_WriteReg(R9, 0x2000046C)  returns 0x00 (0000ms, 1116ms total)
T217C 001:777 JLINK_WriteReg(R10, 0x00000000)  returns 0x00 (0000ms, 1116ms total)
T217C 001:777 JLINK_WriteReg(R11, 0x00000000)  returns 0x00 (0000ms, 1116ms total)
T217C 001:777 JLINK_WriteReg(R12, 0x00000000)  returns 0x00 (0000ms, 1116ms total)
T217C 001:777 JLINK_WriteReg(R13 (SP), 0x20001000)  returns 0x00 (0000ms, 1116ms total)
T217C 001:777 JLINK_WriteReg(R14, 0x20000001)  returns 0x00 (0000ms, 1116ms total)
T217C 001:777 JLINK_WriteReg(R15 (PC), 0x200001BE)  returns 0x00 (0000ms, 1116ms total)
T217C 001:777 JLINK_WriteReg(XPSR, 0x01000000)  returns 0x00 (0000ms, 1116ms total)
T217C 001:777 JLINK_WriteReg(MSP, 0x20001000)  returns 0x00 (0000ms, 1116ms total)
T217C 001:777 JLINK_WriteReg(PSP, 0x20001000)  returns 0x00 (0000ms, 1116ms total)
T217C 001:777 JLINK_WriteReg(CFBP, 0x00000000)  returns 0x00 (0000ms, 1116ms total)
T217C 001:777 JLINK_SetBPEx(Addr = 0x20000000, Type = 0xFFFFFFF2)  returns 0x00000018 (0000ms, 1116ms total)
T217C 001:777 JLINK_Go() (0003ms, 1119ms total)
T217C 001:780 JLINK_IsHalted()  returns FALSE (0001ms, 1120ms total)
T217C 001:785 JLINK_IsHalted() -- CPU_ReadMem(2 bytes @ 0x20000000)  returns TRUE (0006ms, 1125ms total)
T217C 001:791 JLINK_ReadReg(R15 (PC))  returns 0x20000000 (0000ms, 1119ms total)
T217C 001:791 JLINK_ClrBPEx(BPHandle = 0x00000018)  returns 0x00 (0000ms, 1119ms total)
T217C 001:791 JLINK_ReadReg(R0)  returns 0x00000000 (0000ms, 1119ms total)
T217C 001:791 JLINK_WriteReg(R0, 0x00000002)  returns 0x00 (0000ms, 1119ms total)
T217C 001:791 JLINK_WriteReg(R1, 0x0000015C)  returns 0x00 (0000ms, 1119ms total)
T217C 001:791 JLINK_WriteReg(R2, 0x20000470)  returns 0x00 (0000ms, 1119ms total)
T217C 001:791 JLINK_WriteReg(R3, 0x00000000)  returns 0x00 (0000ms, 1119ms total)
T217C 001:791 JLINK_WriteReg(R4, 0x00000000)  returns 0x00 (0000ms, 1119ms total)
T217C 001:791 JLINK_WriteReg(R5, 0x00000000)  returns 0x00 (0000ms, 1119ms total)
T217C 001:791 JLINK_WriteReg(R6, 0x00000000)  returns 0x00 (0000ms, 1119ms total)
T217C 001:791 JLINK_WriteReg(R7, 0x00000000)  returns 0x00 (0000ms, 1119ms total)
T217C 001:791 JLINK_WriteReg(R8, 0x00000000)  returns 0x00 (0000ms, 1119ms total)
T217C 001:791 JLINK_WriteReg(R9, 0x2000046C)  returns 0x00 (0000ms, 1119ms total)
T217C 001:791 JLINK_WriteReg(R10, 0x00000000)  returns 0x00 (0000ms, 1119ms total)
T217C 001:791 JLINK_WriteReg(R11, 0x00000000)  returns 0x00 (0000ms, 1119ms total)
T217C 001:791 JLINK_WriteReg(R12, 0x00000000)  returns 0x00 (0000ms, 1119ms total)
T217C 001:791 JLINK_WriteReg(R13 (SP), 0x20001000)  returns 0x00 (0000ms, 1119ms total)
T217C 001:791 JLINK_WriteReg(R14, 0x20000001)  returns 0x00 (0000ms, 1119ms total)
T217C 001:791 JLINK_WriteReg(R15 (PC), 0x20000052)  returns 0x00 (0000ms, 1119ms total)
T217C 001:791 JLINK_WriteReg(XPSR, 0x01000000)  returns 0x00 (0000ms, 1119ms total)
T217C 001:791 JLINK_WriteReg(MSP, 0x20001000)  returns 0x00 (0000ms, 1119ms total)
T217C 001:791 JLINK_WriteReg(PSP, 0x20001000)  returns 0x00 (0000ms, 1119ms total)
T217C 001:791 JLINK_WriteReg(CFBP, 0x00000000)  returns 0x00 (0000ms, 1119ms total)
T217C 001:791 JLINK_SetBPEx(Addr = 0x20000000, Type = 0xFFFFFFF2)  returns 0x00000019 (0000ms, 1119ms total)
T217C 001:791 JLINK_Go() (0003ms, 1122ms total)
T217C 001:794 JLINK_IsHalted() -- CPU_ReadMem(2 bytes @ 0x20000000)  returns TRUE (0006ms, 1128ms total)
T217C 001:800 JLINK_ReadReg(R15 (PC))  returns 0x20000000 (0000ms, 1122ms total)
T217C 001:800 JLINK_ClrBPEx(BPHandle = 0x00000019)  returns 0x00 (0000ms, 1122ms total)
T217C 001:800 JLINK_ReadReg(R0)  returns 0x00000000 (0000ms, 1122ms total)
T217C 001:856 JLINK_WriteMem(0x20000000, 0x0470 Bytes, ...) - Data: 00 BE 0A E0 0D 78 2D 06 68 40 08 24 40 00 00 D3 ... -- CPU_WriteMem(1136 bytes @ 0x20000000)  returns 0x470 (0017ms, 1139ms total)
T217C 001:873 JLINK_WriteReg(R0, 0x00000000)  returns 0x00 (0000ms, 1139ms total)
T217C 001:873 JLINK_WriteReg(R1, 0x00F42400)  returns 0x00 (0000ms, 1139ms total)
T217C 001:873 JLINK_WriteReg(R2, 0x00000003)  returns 0x00 (0000ms, 1139ms total)
T217C 001:873 JLINK_WriteReg(R3, 0x00000000)  returns 0x00 (0000ms, 1139ms total)
T217C 001:873 JLINK_WriteReg(R4, 0x00000000)  returns 0x00 (0000ms, 1139ms total)
T217C 001:873 JLINK_WriteReg(R5, 0x00000000)  returns 0x00 (0000ms, 1139ms total)
T217C 001:873 JLINK_WriteReg(R6, 0x00000000)  returns 0x00 (0000ms, 1139ms total)
T217C 001:873 JLINK_WriteReg(R7, 0x00000000)  returns 0x00 (0000ms, 1139ms total)
T217C 001:873 JLINK_WriteReg(R8, 0x00000000)  returns 0x00 (0000ms, 1139ms total)
T217C 001:873 JLINK_WriteReg(R9, 0x2000046C)  returns 0x00 (0000ms, 1139ms total)
T217C 001:873 JLINK_WriteReg(R10, 0x00000000)  returns 0x00 (0000ms, 1139ms total)
T217C 001:873 JLINK_WriteReg(R11, 0x00000000)  returns 0x00 (0000ms, 1139ms total)
T217C 001:873 JLINK_WriteReg(R12, 0x00000000)  returns 0x00 (0000ms, 1139ms total)
T217C 001:873 JLINK_WriteReg(R13 (SP), 0x20001000)  returns 0x00 (0000ms, 1139ms total)
T217C 001:873 JLINK_WriteReg(R14, 0x20000001)  returns 0x00 (0000ms, 1139ms total)
T217C 001:873 JLINK_WriteReg(R15 (PC), 0x20000028)  returns 0x00 (0000ms, 1139ms total)
T217C 001:873 JLINK_WriteReg(XPSR, 0x01000000)  returns 0x00 (0000ms, 1139ms total)
T217C 001:873 JLINK_WriteReg(MSP, 0x20001000)  returns 0x00 (0000ms, 1139ms total)
T217C 001:873 JLINK_WriteReg(PSP, 0x20001000)  returns 0x00 (0000ms, 1139ms total)
T217C 001:873 JLINK_WriteReg(CFBP, 0x00000000)  returns 0x00 (0000ms, 1139ms total)
T217C 001:873 JLINK_SetBPEx(Addr = 0x20000000, Type = 0xFFFFFFF2) -- CPU_ReadMem(2 bytes @ 0x20000000)  returns 0x0000001A (0001ms, 1140ms total)
T217C 001:874 JLINK_Go() -- CPU_WriteMem(2 bytes @ 0x20000000) (0004ms, 1144ms total)
T217C 001:878 JLINK_IsHalted() -- CPU_ReadMem(2 bytes @ 0x20000000)  returns TRUE (0006ms, 1150ms total)
T217C 001:884 JLINK_ReadReg(R15 (PC))  returns 0x20000000 (0000ms, 1144ms total)
T217C 001:884 JLINK_ClrBPEx(BPHandle = 0x0000001A)  returns 0x00 (0000ms, 1144ms total)
T217C 001:884 JLINK_ReadReg(R0)  returns 0x00000000 (0000ms, 1144ms total)
T217C 001:884 JLINK_WriteMem(0x20000470, 0x0390 Bytes, ...) - Data: 00 2C 00 20 F5 80 01 00 0F 81 01 00 11 81 01 00 ... -- CPU_WriteMem(912 bytes @ 0x20000470)  returns 0x390 (0013ms, 1157ms total)
T217C 001:897 JLINK_WriteMem(0x20000800, 0x0070 Bytes, ...) - Data: 01 91 00 90 05 9B 04 9A 07 99 06 98 00 F0 E9 F8 ... -- CPU_WriteMem(112 bytes @ 0x20000800)  returns 0x70 (0002ms, 1159ms total)
T217C 001:899 JLINK_WriteReg(R0, 0x00018000)  returns 0x00 (0000ms, 1159ms total)
T217C 001:899 JLINK_WriteReg(R1, 0x00000400)  returns 0x00 (0000ms, 1159ms total)
T217C 001:899 JLINK_WriteReg(R2, 0x20000470)  returns 0x00 (0000ms, 1159ms total)
T217C 001:899 JLINK_WriteReg(R3, 0x00000000)  returns 0x00 (0000ms, 1159ms total)
T217C 001:899 JLINK_WriteReg(R4, 0x00000000)  returns 0x00 (0000ms, 1159ms total)
T217C 001:899 JLINK_WriteReg(R5, 0x00000000)  returns 0x00 (0000ms, 1159ms total)
T217C 001:899 JLINK_WriteReg(R6, 0x00000000)  returns 0x00 (0000ms, 1159ms total)
T217C 001:899 JLINK_WriteReg(R7, 0x00000000)  returns 0x00 (0000ms, 1159ms total)
T217C 001:899 JLINK_WriteReg(R8, 0x00000000)  returns 0x00 (0000ms, 1159ms total)
T217C 001:899 JLINK_WriteReg(R9, 0x2000046C)  returns 0x00 (0000ms, 1159ms total)
T217C 001:899 JLINK_WriteReg(R10, 0x00000000)  returns 0x00 (0000ms, 1159ms total)
T217C 001:899 JLINK_WriteReg(R11, 0x00000000)  returns 0x00 (0000ms, 1159ms total)
T217C 001:899 JLINK_WriteReg(R12, 0x00000000)  returns 0x00 (0000ms, 1159ms total)
T217C 001:899 JLINK_WriteReg(R13 (SP), 0x20001000)  returns 0x00 (0000ms, 1159ms total)
T217C 001:899 JLINK_WriteReg(R14, 0x20000001)  returns 0x00 (0000ms, 1159ms total)
T217C 001:899 JLINK_WriteReg(R15 (PC), 0x200002B2)  returns 0x00 (0000ms, 1159ms total)
T217C 001:899 JLINK_WriteReg(XPSR, 0x01000000)  returns 0x00 (0001ms, 1160ms total)
T217C 001:900 JLINK_WriteReg(MSP, 0x20001000)  returns 0x00 (0000ms, 1160ms total)
T217C 001:900 JLINK_WriteReg(PSP, 0x20001000)  returns 0x00 (0000ms, 1160ms total)
T217C 001:900 JLINK_WriteReg(CFBP, 0x00000000)  returns 0x00 (0000ms, 1160ms total)
T217C 001:900 JLINK_SetBPEx(Addr = 0x20000000, Type = 0xFFFFFFF2)  returns 0x0000001B (0000ms, 1160ms total)
T217C 001:900 JLINK_Go() (0002ms, 1162ms total)
T217C 001:902 JLINK_IsHalted() -- CPU_ReadMem(2 bytes @ 0x20000000)  returns TRUE (0006ms, 1168ms total)
T217C 001:908 JLINK_ReadReg(R15 (PC))  returns 0x20000000 (0000ms, 1162ms total)
T217C 001:908 JLINK_ClrBPEx(BPHandle = 0x0000001B)  returns 0x00 (0000ms, 1162ms total)
T217C 001:908 JLINK_ReadReg(R0)  returns 0x00018400 (0000ms, 1162ms total)
T217C 001:909 JLINK_WriteMem(0x20000470, 0x0390 Bytes, ...) - Data: 00 90 02 E0 92 18 00 98 5B 41 00 28 03 DA 00 20 ... -- CPU_WriteMem(912 bytes @ 0x20000470)  returns 0x390 (0013ms, 1175ms total)
T217C 001:922 JLINK_WriteMem(0x20000800, 0x0070 Bytes, ...) - Data: 18 D0 A5 60 19 48 80 69 C1 B2 19 48 00 F0 A9 F9 ... -- CPU_WriteMem(112 bytes @ 0x20000800)  returns 0x70 (0002ms, 1177ms total)
T217C 001:924 JLINK_WriteReg(R0, 0x00018400)  returns 0x00 (0000ms, 1177ms total)
T217C 001:924 JLINK_WriteReg(R1, 0x00000400)  returns 0x00 (0000ms, 1177ms total)
T217C 001:924 JLINK_WriteReg(R2, 0x20000470)  returns 0x00 (0000ms, 1177ms total)
T217C 001:924 JLINK_WriteReg(R3, 0x00000000)  returns 0x00 (0000ms, 1177ms total)
T217C 001:924 JLINK_WriteReg(R4, 0x00000000)  returns 0x00 (0001ms, 1178ms total)
T217C 001:925 JLINK_WriteReg(R5, 0x00000000)  returns 0x00 (0000ms, 1178ms total)
T217C 001:925 JLINK_WriteReg(R6, 0x00000000)  returns 0x00 (0000ms, 1178ms total)
T217C 001:925 JLINK_WriteReg(R7, 0x00000000)  returns 0x00 (0000ms, 1178ms total)
T217C 001:925 JLINK_WriteReg(R8, 0x00000000)  returns 0x00 (0000ms, 1178ms total)
T217C 001:925 JLINK_WriteReg(R9, 0x2000046C)  returns 0x00 (0000ms, 1178ms total)
T217C 001:925 JLINK_WriteReg(R10, 0x00000000)  returns 0x00 (0000ms, 1178ms total)
T217C 001:925 JLINK_WriteReg(R11, 0x00000000)  returns 0x00 (0000ms, 1178ms total)
T217C 001:925 JLINK_WriteReg(R12, 0x00000000)  returns 0x00 (0000ms, 1178ms total)
T217C 001:925 JLINK_WriteReg(R13 (SP), 0x20001000)  returns 0x00 (0000ms, 1178ms total)
T217C 001:925 JLINK_WriteReg(R14, 0x20000001)  returns 0x00 (0000ms, 1178ms total)
T217C 001:925 JLINK_WriteReg(R15 (PC), 0x200002B2)  returns 0x00 (0000ms, 1178ms total)
T217C 001:925 JLINK_WriteReg(XPSR, 0x01000000)  returns 0x00 (0000ms, 1178ms total)
T217C 001:925 JLINK_WriteReg(MSP, 0x20001000)  returns 0x00 (0000ms, 1178ms total)
T217C 001:925 JLINK_WriteReg(PSP, 0x20001000)  returns 0x00 (0000ms, 1178ms total)
T217C 001:925 JLINK_WriteReg(CFBP, 0x00000000)  returns 0x00 (0000ms, 1178ms total)
T217C 001:925 JLINK_SetBPEx(Addr = 0x20000000, Type = 0xFFFFFFF2)  returns 0x0000001C (0000ms, 1178ms total)
T217C 001:925 JLINK_Go() (0003ms, 1181ms total)
T217C 001:928 JLINK_IsHalted() -- CPU_ReadMem(2 bytes @ 0x20000000)  returns TRUE (0005ms, 1186ms total)
T217C 001:933 JLINK_ReadReg(R15 (PC))  returns 0x20000000 (0000ms, 1181ms total)
T217C 001:933 JLINK_ClrBPEx(BPHandle = 0x0000001C)  returns 0x00 (0000ms, 1181ms total)
T217C 001:933 JLINK_ReadReg(R0)  returns 0x00018800 (0000ms, 1181ms total)
T217C 001:934 JLINK_WriteMem(0x20000470, 0x0390 Bytes, ...) - Data: DC 23 00 20 20 21 02 0C 01 D0 10 21 10 46 02 0A ... -- CPU_WriteMem(912 bytes @ 0x20000470)  returns 0x390 (0013ms, 1194ms total)
T217C 001:947 JLINK_WriteMem(0x20000800, 0x0070 Bytes, ...) - Data: 24 23 43 43 D4 54 9B 18 1C 75 40 1C B8 42 F7 DB ... -- CPU_WriteMem(112 bytes @ 0x20000800)  returns 0x70 (0003ms, 1197ms total)
T217C 001:950 JLINK_WriteReg(R0, 0x00018800)  returns 0x00 (0000ms, 1197ms total)
T217C 001:950 JLINK_WriteReg(R1, 0x00000400)  returns 0x00 (0000ms, 1197ms total)
T217C 001:950 JLINK_WriteReg(R2, 0x20000470)  returns 0x00 (0000ms, 1197ms total)
T217C 001:950 JLINK_WriteReg(R3, 0x00000000)  returns 0x00 (0000ms, 1197ms total)
T217C 001:950 JLINK_WriteReg(R4, 0x00000000)  returns 0x00 (0000ms, 1197ms total)
T217C 001:950 JLINK_WriteReg(R5, 0x00000000)  returns 0x00 (0000ms, 1197ms total)
T217C 001:950 JLINK_WriteReg(R6, 0x00000000)  returns 0x00 (0000ms, 1197ms total)
T217C 001:950 JLINK_WriteReg(R7, 0x00000000)  returns 0x00 (0000ms, 1197ms total)
T217C 001:950 JLINK_WriteReg(R8, 0x00000000)  returns 0x00 (0000ms, 1197ms total)
T217C 001:950 JLINK_WriteReg(R9, 0x2000046C)  returns 0x00 (0000ms, 1197ms total)
T217C 001:950 JLINK_WriteReg(R10, 0x00000000)  returns 0x00 (0000ms, 1197ms total)
T217C 001:950 JLINK_WriteReg(R11, 0x00000000)  returns 0x00 (0000ms, 1197ms total)
T217C 001:950 JLINK_WriteReg(R12, 0x00000000)  returns 0x00 (0000ms, 1197ms total)
T217C 001:950 JLINK_WriteReg(R13 (SP), 0x20001000)  returns 0x00 (0000ms, 1197ms total)
T217C 001:950 JLINK_WriteReg(R14, 0x20000001)  returns 0x00 (0000ms, 1197ms total)
T217C 001:950 JLINK_WriteReg(R15 (PC), 0x200002B2)  returns 0x00 (0000ms, 1197ms total)
T217C 001:950 JLINK_WriteReg(XPSR, 0x01000000)  returns 0x00 (0000ms, 1197ms total)
T217C 001:950 JLINK_WriteReg(MSP, 0x20001000)  returns 0x00 (0000ms, 1197ms total)
T217C 001:950 JLINK_WriteReg(PSP, 0x20001000)  returns 0x00 (0000ms, 1197ms total)
T217C 001:950 JLINK_WriteReg(CFBP, 0x00000000)  returns 0x00 (0000ms, 1197ms total)
T217C 001:950 JLINK_SetBPEx(Addr = 0x20000000, Type = 0xFFFFFFF2)  returns 0x0000001D (0000ms, 1197ms total)
T217C 001:950 JLINK_Go() (0003ms, 1200ms total)
T217C 001:953 JLINK_IsHalted() -- CPU_ReadMem(2 bytes @ 0x20000000)  returns TRUE (0005ms, 1205ms total)
T217C 001:958 JLINK_ReadReg(R15 (PC))  returns 0x20000000 (0000ms, 1200ms total)
T217C 001:958 JLINK_ClrBPEx(BPHandle = 0x0000001D)  returns 0x00 (0000ms, 1200ms total)
T217C 001:958 JLINK_ReadReg(R0)  returns 0x00018C00 (0000ms, 1200ms total)
T217C 001:959 JLINK_WriteMem(0x20000470, 0x0390 Bytes, ...) - Data: 00 20 C3 E7 30 20 00 20 80 E2 00 E0 00 E1 00 E0 ... -- CPU_WriteMem(912 bytes @ 0x20000470)  returns 0x390 (0013ms, 1213ms total)
T217C 001:972 JLINK_WriteMem(0x20000800, 0x0070 Bytes, ...) - Data: 00 65 00 40 00 20 00 20 00 05 00 50 40 A0 00 40 ... -- CPU_WriteMem(112 bytes @ 0x20000800)  returns 0x70 (0003ms, 1216ms total)
T217C 001:975 JLINK_WriteReg(R0, 0x00018C00)  returns 0x00 (0000ms, 1216ms total)
T217C 001:975 JLINK_WriteReg(R1, 0x00000400)  returns 0x00 (0000ms, 1216ms total)
T217C 001:975 JLINK_WriteReg(R2, 0x20000470)  returns 0x00 (0000ms, 1216ms total)
T217C 001:975 JLINK_WriteReg(R3, 0x00000000)  returns 0x00 (0000ms, 1216ms total)
T217C 001:975 JLINK_WriteReg(R4, 0x00000000)  returns 0x00 (0000ms, 1216ms total)
T217C 001:975 JLINK_WriteReg(R5, 0x00000000)  returns 0x00 (0000ms, 1216ms total)
T217C 001:975 JLINK_WriteReg(R6, 0x00000000)  returns 0x00 (0000ms, 1216ms total)
T217C 001:975 JLINK_WriteReg(R7, 0x00000000)  returns 0x00 (0000ms, 1216ms total)
T217C 001:975 JLINK_WriteReg(R8, 0x00000000)  returns 0x00 (0000ms, 1216ms total)
T217C 001:975 JLINK_WriteReg(R9, 0x2000046C)  returns 0x00 (0000ms, 1216ms total)
T217C 001:975 JLINK_WriteReg(R10, 0x00000000)  returns 0x00 (0000ms, 1216ms total)
T217C 001:975 JLINK_WriteReg(R11, 0x00000000)  returns 0x00 (0000ms, 1216ms total)
T217C 001:975 JLINK_WriteReg(R12, 0x00000000)  returns 0x00 (0000ms, 1216ms total)
T217C 001:975 JLINK_WriteReg(R13 (SP), 0x20001000)  returns 0x00 (0000ms, 1216ms total)
T217C 001:975 JLINK_WriteReg(R14, 0x20000001)  returns 0x00 (0000ms, 1216ms total)
T217C 001:975 JLINK_WriteReg(R15 (PC), 0x200002B2)  returns 0x00 (0000ms, 1216ms total)
T217C 001:975 JLINK_WriteReg(XPSR, 0x01000000)  returns 0x00 (0000ms, 1216ms total)
T217C 001:975 JLINK_WriteReg(MSP, 0x20001000)  returns 0x00 (0000ms, 1216ms total)
T217C 001:975 JLINK_WriteReg(PSP, 0x20001000)  returns 0x00 (0000ms, 1216ms total)
T217C 001:975 JLINK_WriteReg(CFBP, 0x00000000)  returns 0x00 (0000ms, 1216ms total)
T217C 001:975 JLINK_SetBPEx(Addr = 0x20000000, Type = 0xFFFFFFF2)  returns 0x0000001E (0000ms, 1216ms total)
T217C 001:975 JLINK_Go() (0003ms, 1219ms total)
T217C 001:978 JLINK_IsHalted() -- CPU_ReadMem(2 bytes @ 0x20000000)  returns TRUE (0006ms, 1225ms total)
T217C 001:984 JLINK_ReadReg(R15 (PC))  returns 0x20000000 (0000ms, 1219ms total)
T217C 001:984 JLINK_ClrBPEx(BPHandle = 0x0000001E)  returns 0x00 (0000ms, 1219ms total)
T217C 001:984 JLINK_ReadReg(R0)  returns 0x00019000 (0000ms, 1219ms total)
T217C 001:985 JLINK_WriteMem(0x20000470, 0x0390 Bytes, ...) - Data: 04 D0 13 E0 01 26 F6 E7 01 25 F8 E7 68 46 51 DF ... -- CPU_WriteMem(912 bytes @ 0x20000470)  returns 0x390 (0013ms, 1232ms total)
T217C 001:998 JLINK_WriteMem(0x20000800, 0x0070 Bytes, ...) - Data: 64 1C E2 B2 B1 54 29 78 80 1C 08 18 28 70 00 20 ... -- CPU_WriteMem(112 bytes @ 0x20000800)  returns 0x70 (0003ms, 1235ms total)
T217C 002:001 JLINK_WriteReg(R0, 0x00019000)  returns 0x00 (0000ms, 1235ms total)
T217C 002:001 JLINK_WriteReg(R1, 0x00000400)  returns 0x00 (0000ms, 1235ms total)
T217C 002:001 JLINK_WriteReg(R2, 0x20000470)  returns 0x00 (0000ms, 1235ms total)
T217C 002:001 JLINK_WriteReg(R3, 0x00000000)  returns 0x00 (0000ms, 1235ms total)
T217C 002:001 JLINK_WriteReg(R4, 0x00000000)  returns 0x00 (0000ms, 1235ms total)
T217C 002:001 JLINK_WriteReg(R5, 0x00000000)  returns 0x00 (0000ms, 1235ms total)
T217C 002:001 JLINK_WriteReg(R6, 0x00000000)  returns 0x00 (0000ms, 1235ms total)
T217C 002:001 JLINK_WriteReg(R7, 0x00000000)  returns 0x00 (0000ms, 1235ms total)
T217C 002:001 JLINK_WriteReg(R8, 0x00000000)  returns 0x00 (0000ms, 1235ms total)
T217C 002:001 JLINK_WriteReg(R9, 0x2000046C)  returns 0x00 (0000ms, 1235ms total)
T217C 002:001 JLINK_WriteReg(R10, 0x00000000)  returns 0x00 (0000ms, 1235ms total)
T217C 002:001 JLINK_WriteReg(R11, 0x00000000)  returns 0x00 (0000ms, 1235ms total)
T217C 002:001 JLINK_WriteReg(R12, 0x00000000)  returns 0x00 (0000ms, 1235ms total)
T217C 002:001 JLINK_WriteReg(R13 (SP), 0x20001000)  returns 0x00 (0000ms, 1235ms total)
T217C 002:001 JLINK_WriteReg(R14, 0x20000001)  returns 0x00 (0000ms, 1235ms total)
T217C 002:001 JLINK_WriteReg(R15 (PC), 0x200002B2)  returns 0x00 (0000ms, 1235ms total)
T217C 002:001 JLINK_WriteReg(XPSR, 0x01000000)  returns 0x00 (0000ms, 1235ms total)
T217C 002:001 JLINK_WriteReg(MSP, 0x20001000)  returns 0x00 (0000ms, 1235ms total)
T217C 002:001 JLINK_WriteReg(PSP, 0x20001000)  returns 0x00 (0000ms, 1235ms total)
T217C 002:001 JLINK_WriteReg(CFBP, 0x00000000)  returns 0x00 (0000ms, 1235ms total)
T217C 002:001 JLINK_SetBPEx(Addr = 0x20000000, Type = 0xFFFFFFF2)  returns 0x0000001F (0000ms, 1235ms total)
T217C 002:001 JLINK_Go() (0003ms, 1238ms total)
T217C 002:004 JLINK_IsHalted() -- CPU_ReadMem(2 bytes @ 0x20000000)  returns TRUE (0006ms, 1244ms total)
T217C 002:010 JLINK_ReadReg(R15 (PC))  returns 0x20000000 (0000ms, 1238ms total)
T217C 002:010 JLINK_ClrBPEx(BPHandle = 0x0000001F)  returns 0x00 (0000ms, 1238ms total)
T217C 002:010 JLINK_ReadReg(R0)  returns 0x00019400 (0000ms, 1238ms total)
T217C 002:011 JLINK_WriteMem(0x20000470, 0x0390 Bytes, ...) - Data: 03 28 01 D1 02 20 48 70 10 BD 13 4B 04 20 18 60 ... -- CPU_WriteMem(912 bytes @ 0x20000470)  returns 0x390 (0013ms, 1251ms total)
T217C 002:024 JLINK_WriteMem(0x20000800, 0x0070 Bytes, ...) - Data: 70 47 00 00 12 49 48 68 C0 05 C0 0D 19 D0 10 38 ... -- CPU_WriteMem(112 bytes @ 0x20000800)  returns 0x70 (0003ms, 1254ms total)
T217C 002:027 JLINK_WriteReg(R0, 0x00019400)  returns 0x00 (0000ms, 1254ms total)
T217C 002:027 JLINK_WriteReg(R1, 0x00000400)  returns 0x00 (0000ms, 1254ms total)
T217C 002:027 JLINK_WriteReg(R2, 0x20000470)  returns 0x00 (0000ms, 1254ms total)
T217C 002:027 JLINK_WriteReg(R3, 0x00000000)  returns 0x00 (0000ms, 1254ms total)
T217C 002:027 JLINK_WriteReg(R4, 0x00000000)  returns 0x00 (0000ms, 1254ms total)
T217C 002:028 JLINK_WriteReg(R5, 0x00000000)  returns 0x00 (0000ms, 1254ms total)
T217C 002:028 JLINK_WriteReg(R6, 0x00000000)  returns 0x00 (0000ms, 1254ms total)
T217C 002:028 JLINK_WriteReg(R7, 0x00000000)  returns 0x00 (0000ms, 1254ms total)
T217C 002:028 JLINK_WriteReg(R8, 0x00000000)  returns 0x00 (0000ms, 1254ms total)
T217C 002:028 JLINK_WriteReg(R9, 0x2000046C)  returns 0x00 (0000ms, 1254ms total)
T217C 002:028 JLINK_WriteReg(R10, 0x00000000)  returns 0x00 (0000ms, 1254ms total)
T217C 002:028 JLINK_WriteReg(R11, 0x00000000)  returns 0x00 (0000ms, 1254ms total)
T217C 002:028 JLINK_WriteReg(R12, 0x00000000)  returns 0x00 (0000ms, 1254ms total)
T217C 002:028 JLINK_WriteReg(R13 (SP), 0x20001000)  returns 0x00 (0000ms, 1254ms total)
T217C 002:028 JLINK_WriteReg(R14, 0x20000001)  returns 0x00 (0000ms, 1254ms total)
T217C 002:028 JLINK_WriteReg(R15 (PC), 0x200002B2)  returns 0x00 (0000ms, 1254ms total)
T217C 002:028 JLINK_WriteReg(XPSR, 0x01000000)  returns 0x00 (0000ms, 1254ms total)
T217C 002:028 JLINK_WriteReg(MSP, 0x20001000)  returns 0x00 (0000ms, 1254ms total)
T217C 002:028 JLINK_WriteReg(PSP, 0x20001000)  returns 0x00 (0000ms, 1254ms total)
T217C 002:028 JLINK_WriteReg(CFBP, 0x00000000)  returns 0x00 (0000ms, 1254ms total)
T217C 002:028 JLINK_SetBPEx(Addr = 0x20000000, Type = 0xFFFFFFF2)  returns 0x00000020 (0000ms, 1254ms total)
T217C 002:028 JLINK_Go() (0003ms, 1257ms total)
T217C 002:031 JLINK_IsHalted() -- CPU_ReadMem(2 bytes @ 0x20000000)  returns TRUE (0005ms, 1262ms total)
T217C 002:036 JLINK_ReadReg(R15 (PC))  returns 0x20000000 (0000ms, 1257ms total)
T217C 002:036 JLINK_ClrBPEx(BPHandle = 0x00000020)  returns 0x00 (0000ms, 1257ms total)
T217C 002:036 JLINK_ReadReg(R0)  returns 0x00019800 (0000ms, 1257ms total)
T217C 002:037 JLINK_WriteMem(0x20000470, 0x0390 Bytes, ...) - Data: 41 68 40 78 18 22 50 43 08 18 70 47 F8 B5 15 46 ... -- CPU_WriteMem(912 bytes @ 0x20000470)  returns 0x390 (0013ms, 1270ms total)
T217C 002:050 JLINK_WriteMem(0x20000800, 0x0070 Bytes, ...) - Data: 00 00 00 00 00 00 00 00 00 00 00 00 00 00 00 00 ... -- CPU_WriteMem(112 bytes @ 0x20000800)  returns 0x70 (0003ms, 1273ms total)
T217C 002:053 JLINK_WriteReg(R0, 0x00019800)  returns 0x00 (0000ms, 1273ms total)
T217C 002:053 JLINK_WriteReg(R1, 0x0000015C)  returns 0x00 (0000ms, 1273ms total)
T217C 002:053 JLINK_WriteReg(R2, 0x20000470)  returns 0x00 (0000ms, 1273ms total)
T217C 002:053 JLINK_WriteReg(R3, 0x00000000)  returns 0x00 (0000ms, 1273ms total)
T217C 002:053 JLINK_WriteReg(R4, 0x00000000)  returns 0x00 (0000ms, 1273ms total)
T217C 002:053 JLINK_WriteReg(R5, 0x00000000)  returns 0x00 (0000ms, 1273ms total)
T217C 002:053 JLINK_WriteReg(R6, 0x00000000)  returns 0x00 (0000ms, 1273ms total)
T217C 002:053 JLINK_WriteReg(R7, 0x00000000)  returns 0x00 (0000ms, 1273ms total)
T217C 002:053 JLINK_WriteReg(R8, 0x00000000)  returns 0x00 (0000ms, 1273ms total)
T217C 002:053 JLINK_WriteReg(R9, 0x2000046C)  returns 0x00 (0000ms, 1273ms total)
T217C 002:053 JLINK_WriteReg(R10, 0x00000000)  returns 0x00 (0000ms, 1273ms total)
T217C 002:053 JLINK_WriteReg(R11, 0x00000000)  returns 0x00 (0000ms, 1273ms total)
T217C 002:053 JLINK_WriteReg(R12, 0x00000000)  returns 0x00 (0000ms, 1273ms total)
T217C 002:053 JLINK_WriteReg(R13 (SP), 0x20001000)  returns 0x00 (0000ms, 1273ms total)
T217C 002:053 JLINK_WriteReg(R14, 0x20000001)  returns 0x00 (0000ms, 1273ms total)
T217C 002:053 JLINK_WriteReg(R15 (PC), 0x200002B2)  returns 0x00 (0000ms, 1273ms total)
T217C 002:053 JLINK_WriteReg(XPSR, 0x01000000)  returns 0x00 (0000ms, 1273ms total)
T217C 002:053 JLINK_WriteReg(MSP, 0x20001000)  returns 0x00 (0000ms, 1273ms total)
T217C 002:053 JLINK_WriteReg(PSP, 0x20001000)  returns 0x00 (0000ms, 1273ms total)
T217C 002:053 JLINK_WriteReg(CFBP, 0x00000000)  returns 0x00 (0000ms, 1273ms total)
T217C 002:053 JLINK_SetBPEx(Addr = 0x20000000, Type = 0xFFFFFFF2)  returns 0x00000021 (0000ms, 1273ms total)
T217C 002:053 JLINK_Go() (0003ms, 1276ms total)
T217C 002:056 JLINK_IsHalted() -- CPU_ReadMem(2 bytes @ 0x20000000)  returns TRUE (0006ms, 1282ms total)
T217C 002:062 JLINK_ReadReg(R15 (PC))  returns 0x20000000 (0000ms, 1276ms total)
T217C 002:062 JLINK_ClrBPEx(BPHandle = 0x00000021)  returns 0x00 (0000ms, 1276ms total)
T217C 002:062 JLINK_ReadReg(R0)  returns 0x0001995C (0000ms, 1276ms total)
T217C 002:062 JLINK_WriteReg(R0, 0x00000003)  returns 0x00 (0001ms, 1277ms total)
T217C 002:063 JLINK_WriteReg(R1, 0x0000015C)  returns 0x00 (0000ms, 1277ms total)
T217C 002:063 JLINK_WriteReg(R2, 0x20000470)  returns 0x00 (0000ms, 1277ms total)
T217C 002:063 JLINK_WriteReg(R3, 0x00000000)  returns 0x00 (0000ms, 1277ms total)
T217C 002:063 JLINK_WriteReg(R4, 0x00000000)  returns 0x00 (0000ms, 1277ms total)
T217C 002:063 JLINK_WriteReg(R5, 0x00000000)  returns 0x00 (0000ms, 1277ms total)
T217C 002:063 JLINK_WriteReg(R6, 0x00000000)  returns 0x00 (0000ms, 1277ms total)
T217C 002:063 JLINK_WriteReg(R7, 0x00000000)  returns 0x00 (0000ms, 1277ms total)
T217C 002:063 JLINK_WriteReg(R8, 0x00000000)  returns 0x00 (0000ms, 1277ms total)
T217C 002:063 JLINK_WriteReg(R9, 0x2000046C)  returns 0x00 (0000ms, 1277ms total)
T217C 002:063 JLINK_WriteReg(R10, 0x00000000)  returns 0x00 (0000ms, 1277ms total)
T217C 002:063 JLINK_WriteReg(R11, 0x00000000)  returns 0x00 (0000ms, 1277ms total)
T217C 002:063 JLINK_WriteReg(R12, 0x00000000)  returns 0x00 (0000ms, 1277ms total)
T217C 002:063 JLINK_WriteReg(R13 (SP), 0x20001000)  returns 0x00 (0000ms, 1277ms total)
T217C 002:063 JLINK_WriteReg(R14, 0x20000001)  returns 0x00 (0000ms, 1277ms total)
T217C 002:063 JLINK_WriteReg(R15 (PC), 0x20000052)  returns 0x00 (0000ms, 1277ms total)
T217C 002:063 JLINK_WriteReg(XPSR, 0x01000000)  returns 0x00 (0000ms, 1277ms total)
T217C 002:063 JLINK_WriteReg(MSP, 0x20001000)  returns 0x00 (0000ms, 1277ms total)
T217C 002:063 JLINK_WriteReg(PSP, 0x20001000)  returns 0x00 (0000ms, 1277ms total)
T217C 002:063 JLINK_WriteReg(CFBP, 0x00000000)  returns 0x00 (0000ms, 1277ms total)
T217C 002:063 JLINK_SetBPEx(Addr = 0x20000000, Type = 0xFFFFFFF2)  returns 0x00000022 (0000ms, 1277ms total)
T217C 002:063 JLINK_Go() (0003ms, 1280ms total)
T217C 002:066 JLINK_IsHalted() -- CPU_ReadMem(2 bytes @ 0x20000000)  returns TRUE (0006ms, 1286ms total)
T217C 002:072 JLINK_ReadReg(R15 (PC))  returns 0x20000000 (0001ms, 1281ms total)
T217C 002:073 JLINK_ClrBPEx(BPHandle = 0x00000022)  returns 0x00 (0000ms, 1281ms total)
T217C 002:073 JLINK_ReadReg(R0)  returns 0x00000000 (0000ms, 1281ms total)
T217C 002:128 JLINK_WriteMem(0x20000000, 0x0002 Bytes, ...) - Data: FE E7 -- CPU_WriteMem(2 bytes @ 0x20000000)  returns 0x02 (0001ms, 1282ms total)
T217C 002:136 JLINK_Close() >0x42 TIF> >0x28 TIF> >0x35 TIF> (0005ms, 1287ms total)
T217C 002:136  (0005ms, 1287ms total)
T217C 002:136 Closed (0005ms, 1287ms total)
