huddlwenf/vedlegg_E1534A/Vedlegg_Budsjett.pdf

Budsjett:
Vare | Antall | Pris pr. Stk Pris totalt
Android telefon | 1 | 6000 | 6000
APD 5090 | 3 | 37,6 | 112,8
555timer, smd | 3 | 10,28 | 30,84
555timer, through | 3 | 9,86 | 29,58
Balun, Johanson | 2 | 7,58 | 15,16
Antenne, Johanson | 2 | 6,98 | 13,96
Batteri, LIR2450 | 5 | 20,4 | 102
Batteriholder | 5 | 2,85 | 14,25
PCB-bestilling | 1 | 2500 | 2500
SUM | 8818,59
