huddlwenf/vedlegg_E1534A/Vedlegg_2_Kretsskjema_PCB-utlegg_PDF/Batteri copper bottom.pdf

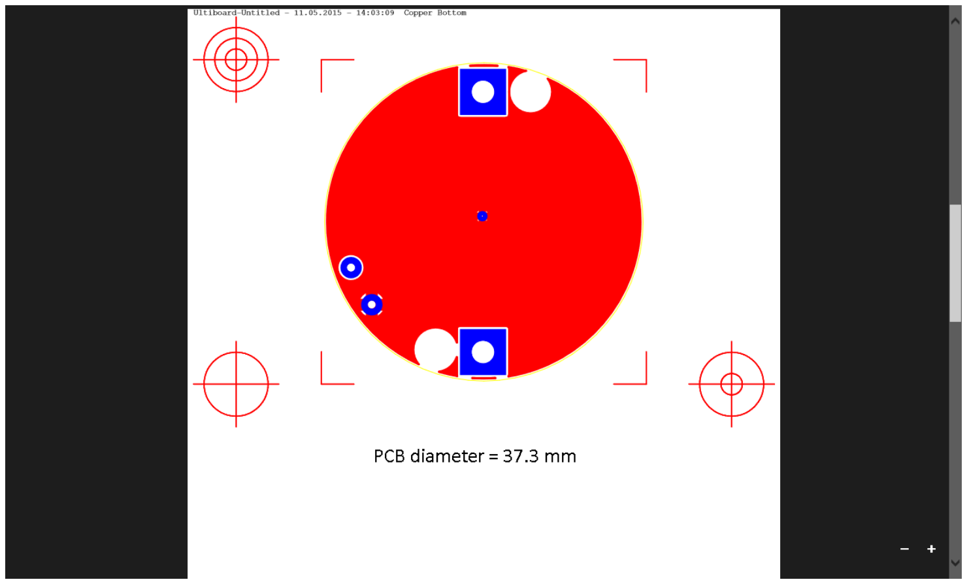
[picture p4: page 1]
