huddlwenf/vedlegg_E1534A/Vedlegg_2_Kretsskjema_PCB-utlegg_PDF/Batteri copper top.pdf

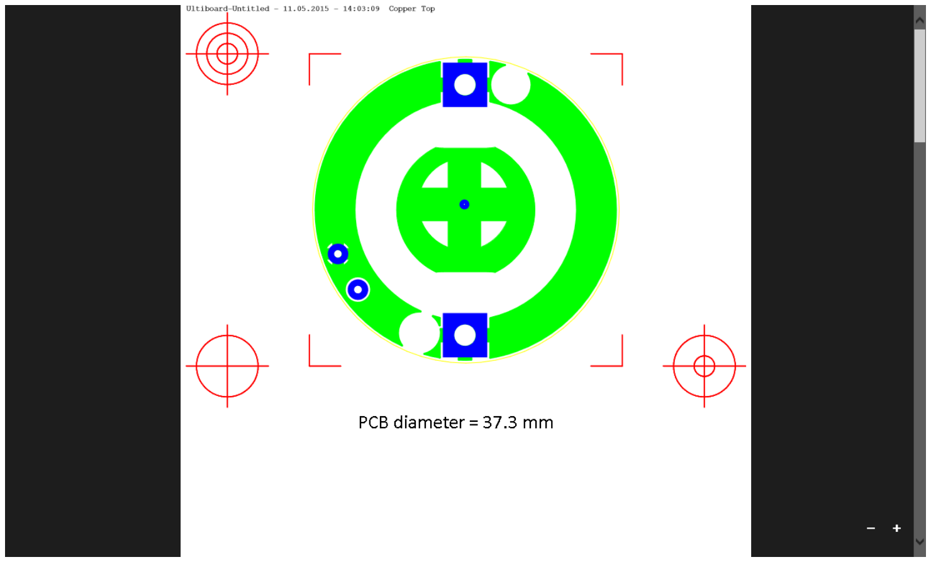
[picture p5: page 1]
