huddlwenf/vedlegg_E1534A/Vedlegg_2_Kretsskjema_PCB-utlegg_PDF/Batteri silkscreen.pdf

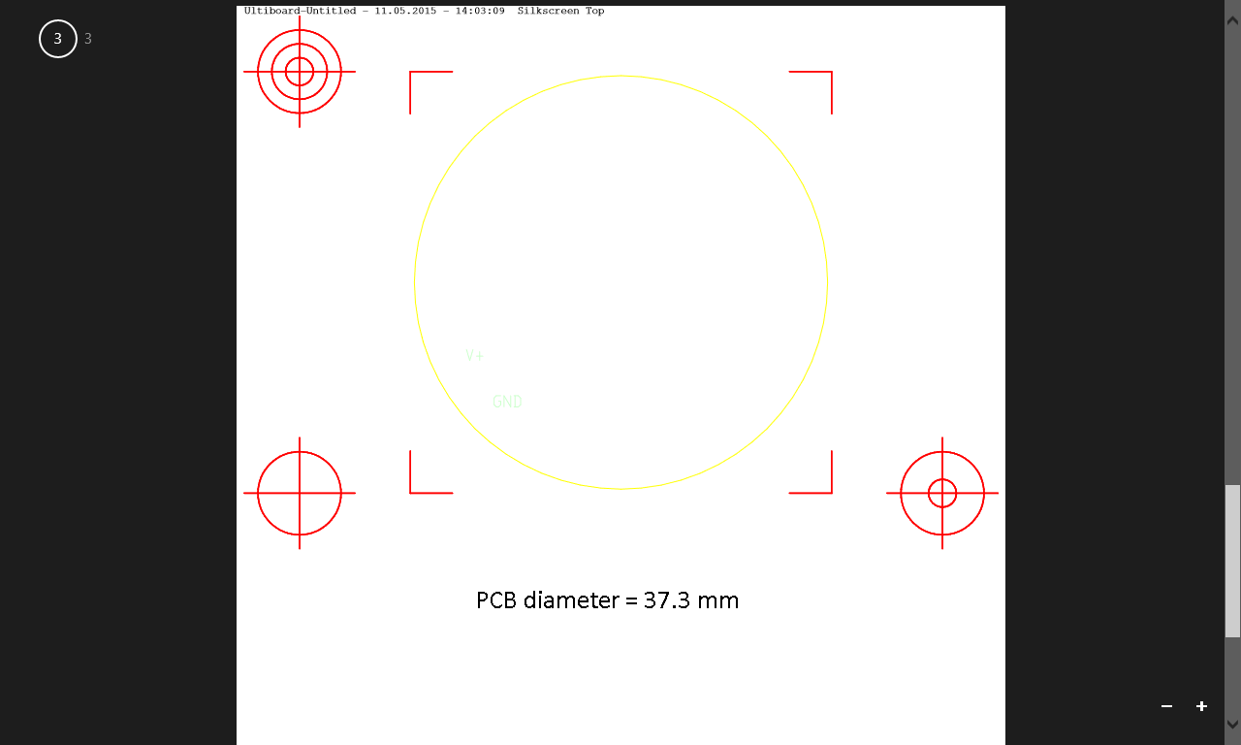
[picture p6: page 1]
