huddlwenf/vedlegg_E1534A/Vedlegg_2_Kretsskjema_PCB-utlegg_PDF/Hovedkort copper bottom.pdf

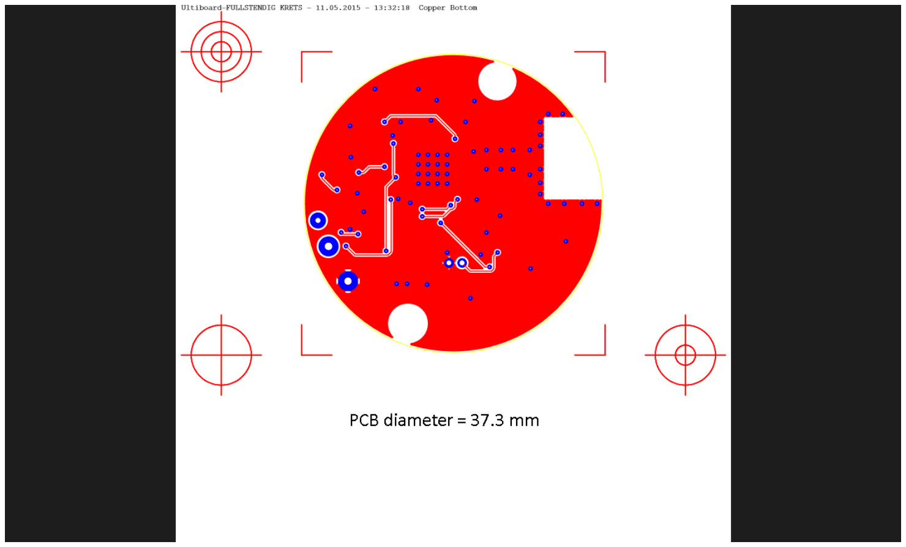
[picture p7: page 1]
