huddlwenf/vedlegg_E1534A/Vedlegg_2_Kretsskjema_PCB-utlegg_PDF/Hovedkort copper top.pdf

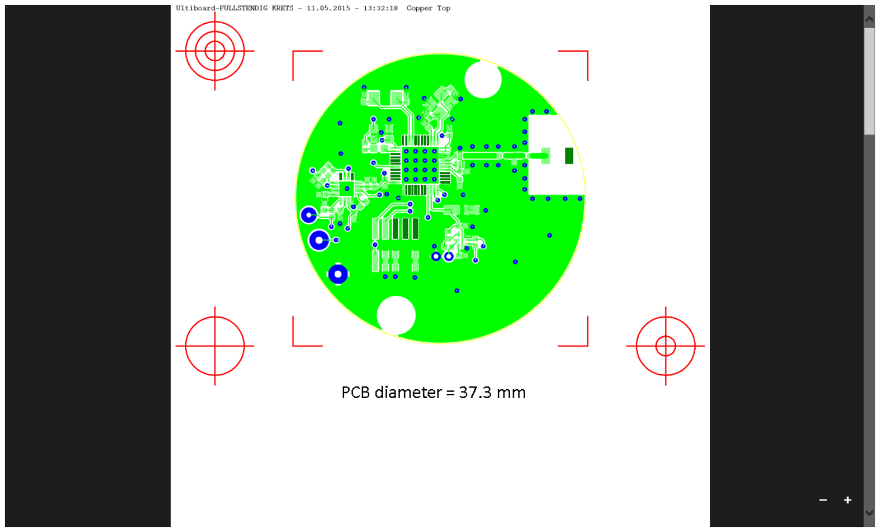
[picture p8: page 1]
