huddlwenf/vedlegg_E1534A/Vedlegg_2_Kretsskjema_PCB-utlegg_PDF/Hovedkort silkscreen.pdf

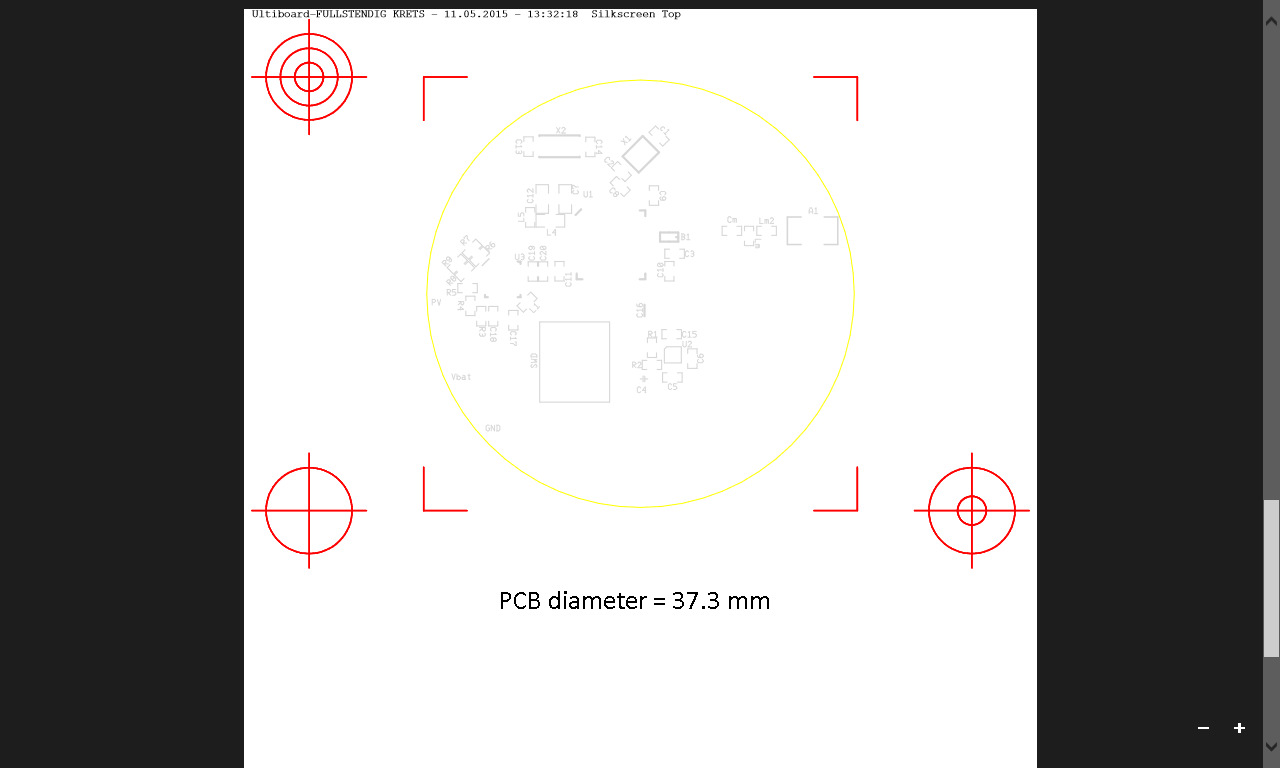
[picture p9: page 1]
