huddlwenf/vedlegg_E1534A/Vedlegg_2_Kretsskjema_PCB-utlegg_PDF/FULLSTENDIG KRETS.pdf

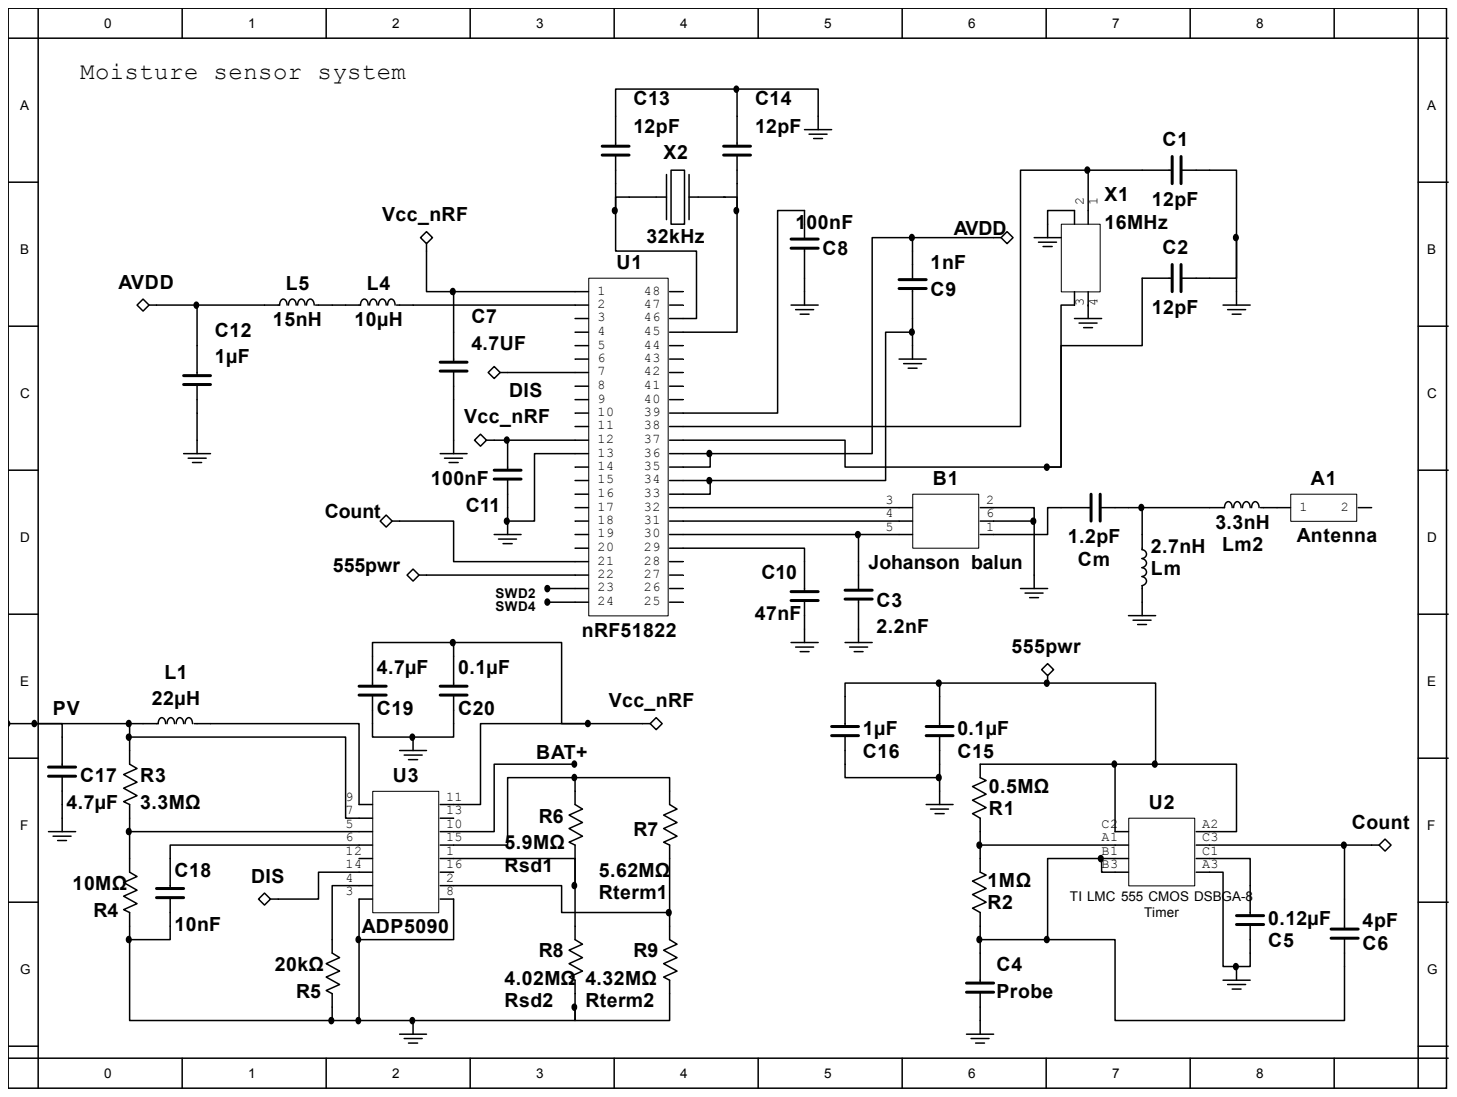
[picture p13: page 1]

TI LMC 555 CMOS DSBGA-8
